princeton-rover-team/electrical/BMS Board/BMS Board.kicad_pcb

## KiCad design BMS Board/BMS Board.kicad_pcb (2026-09-24)

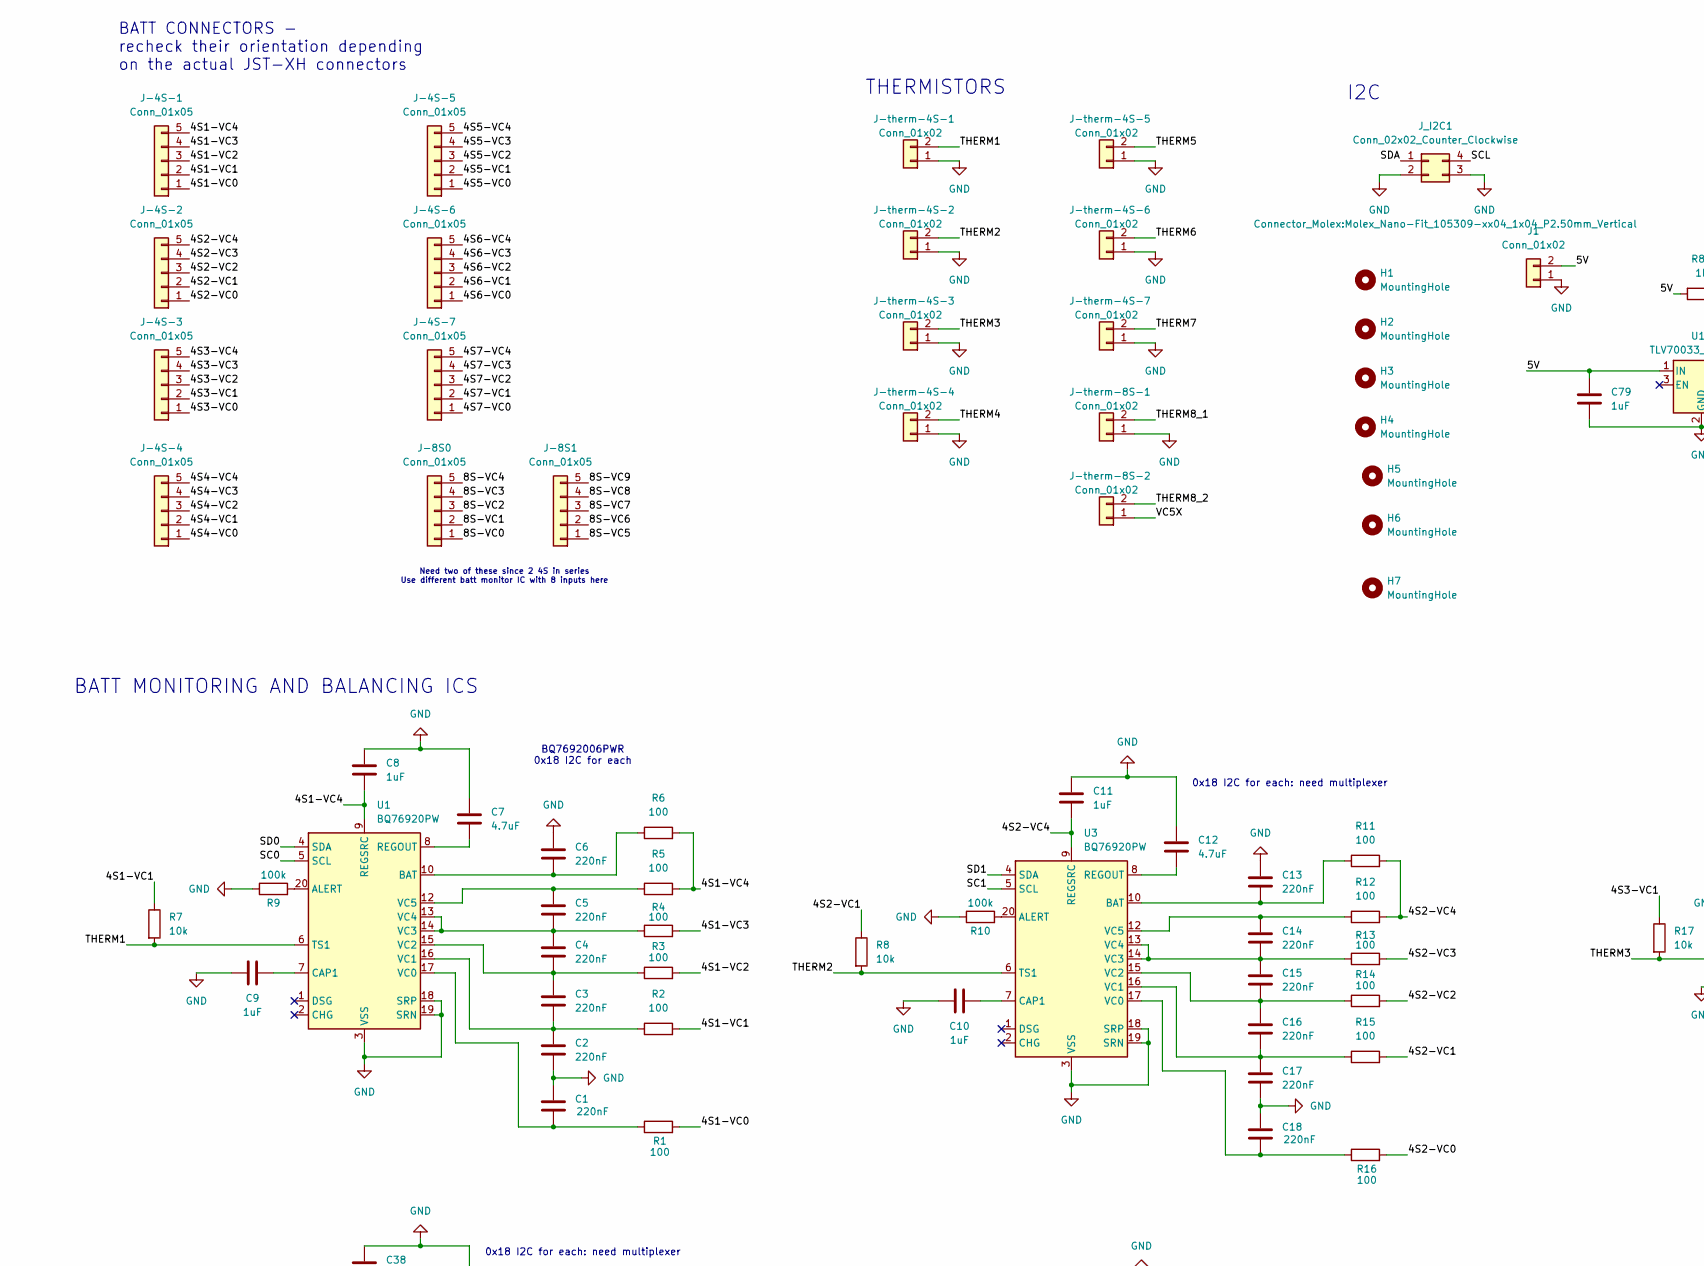
[picture p1: schematic BMS Board.kicad_sch, part in row 1, column 1]

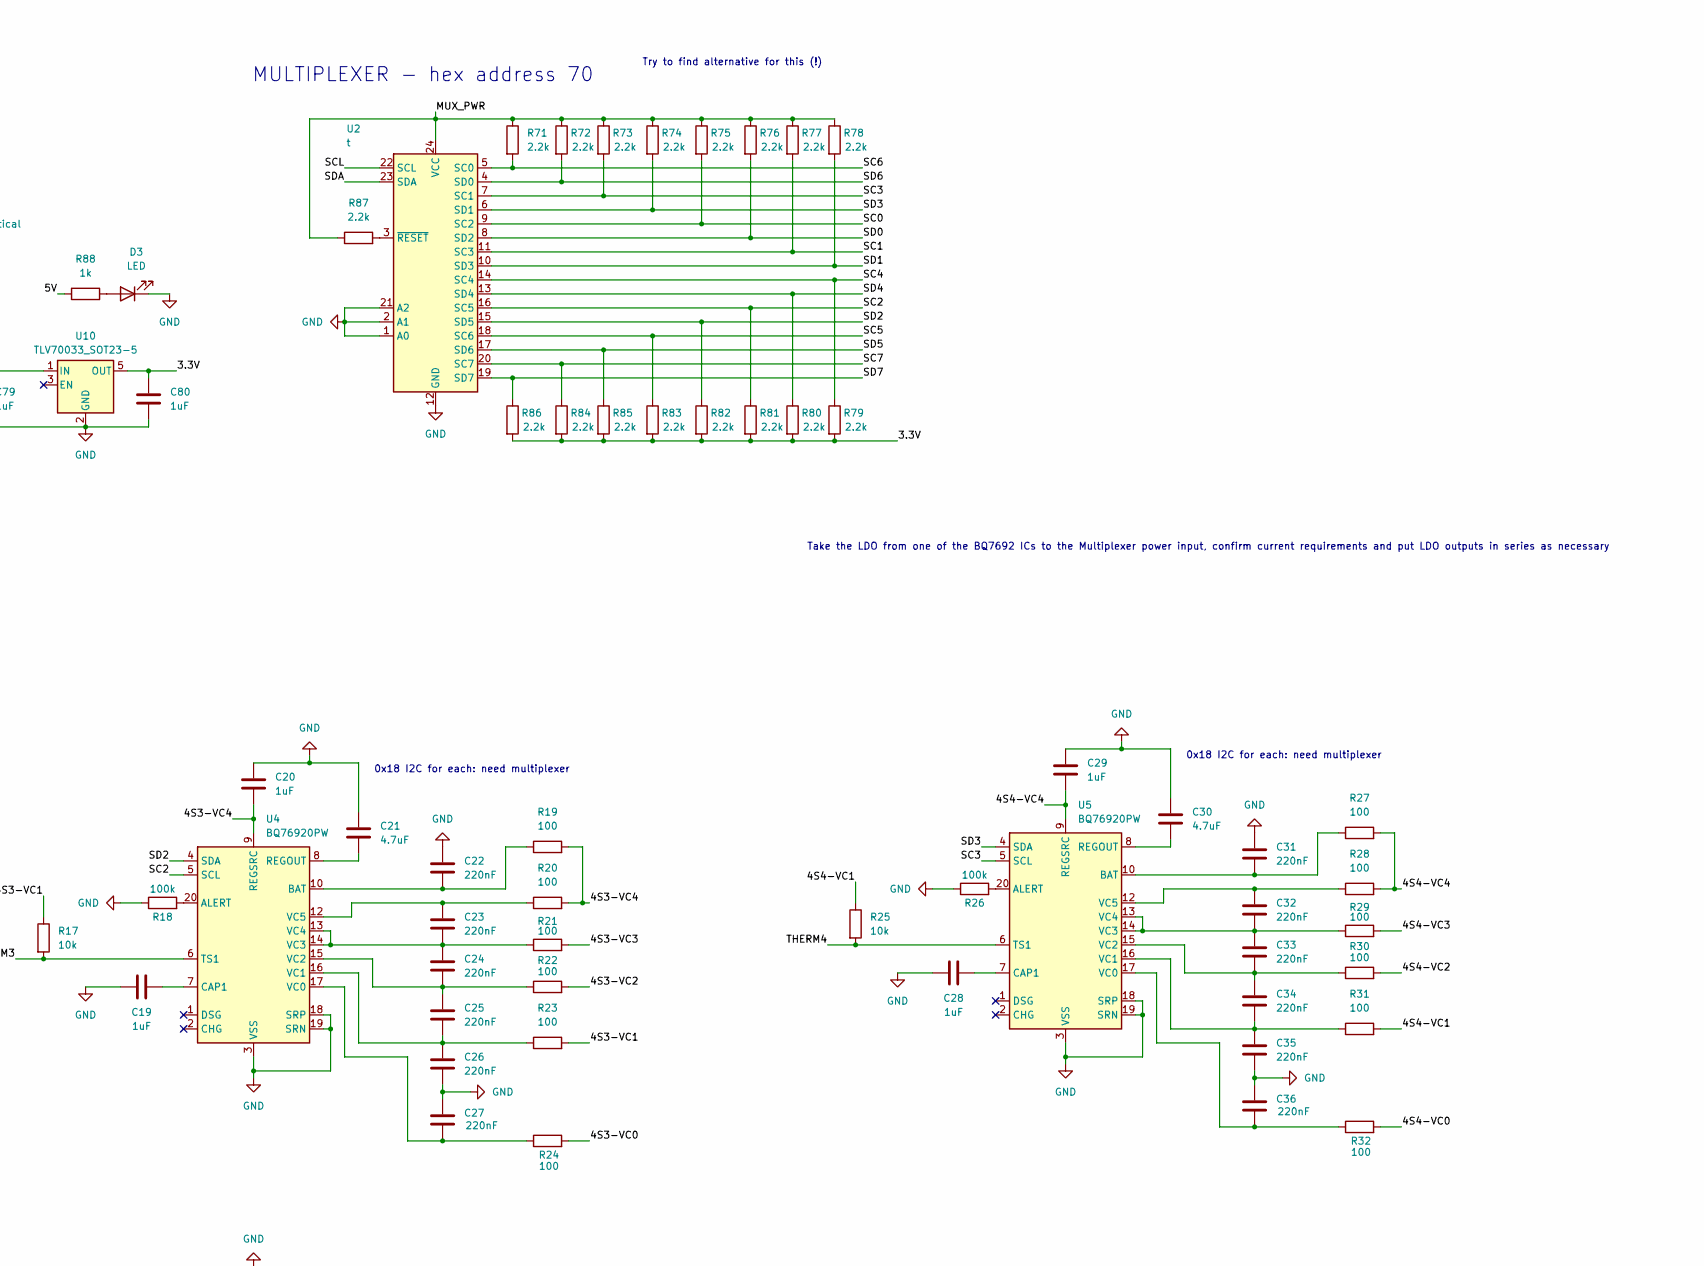
[picture p2: schematic BMS Board.kicad_sch, part in row 1, column 2]

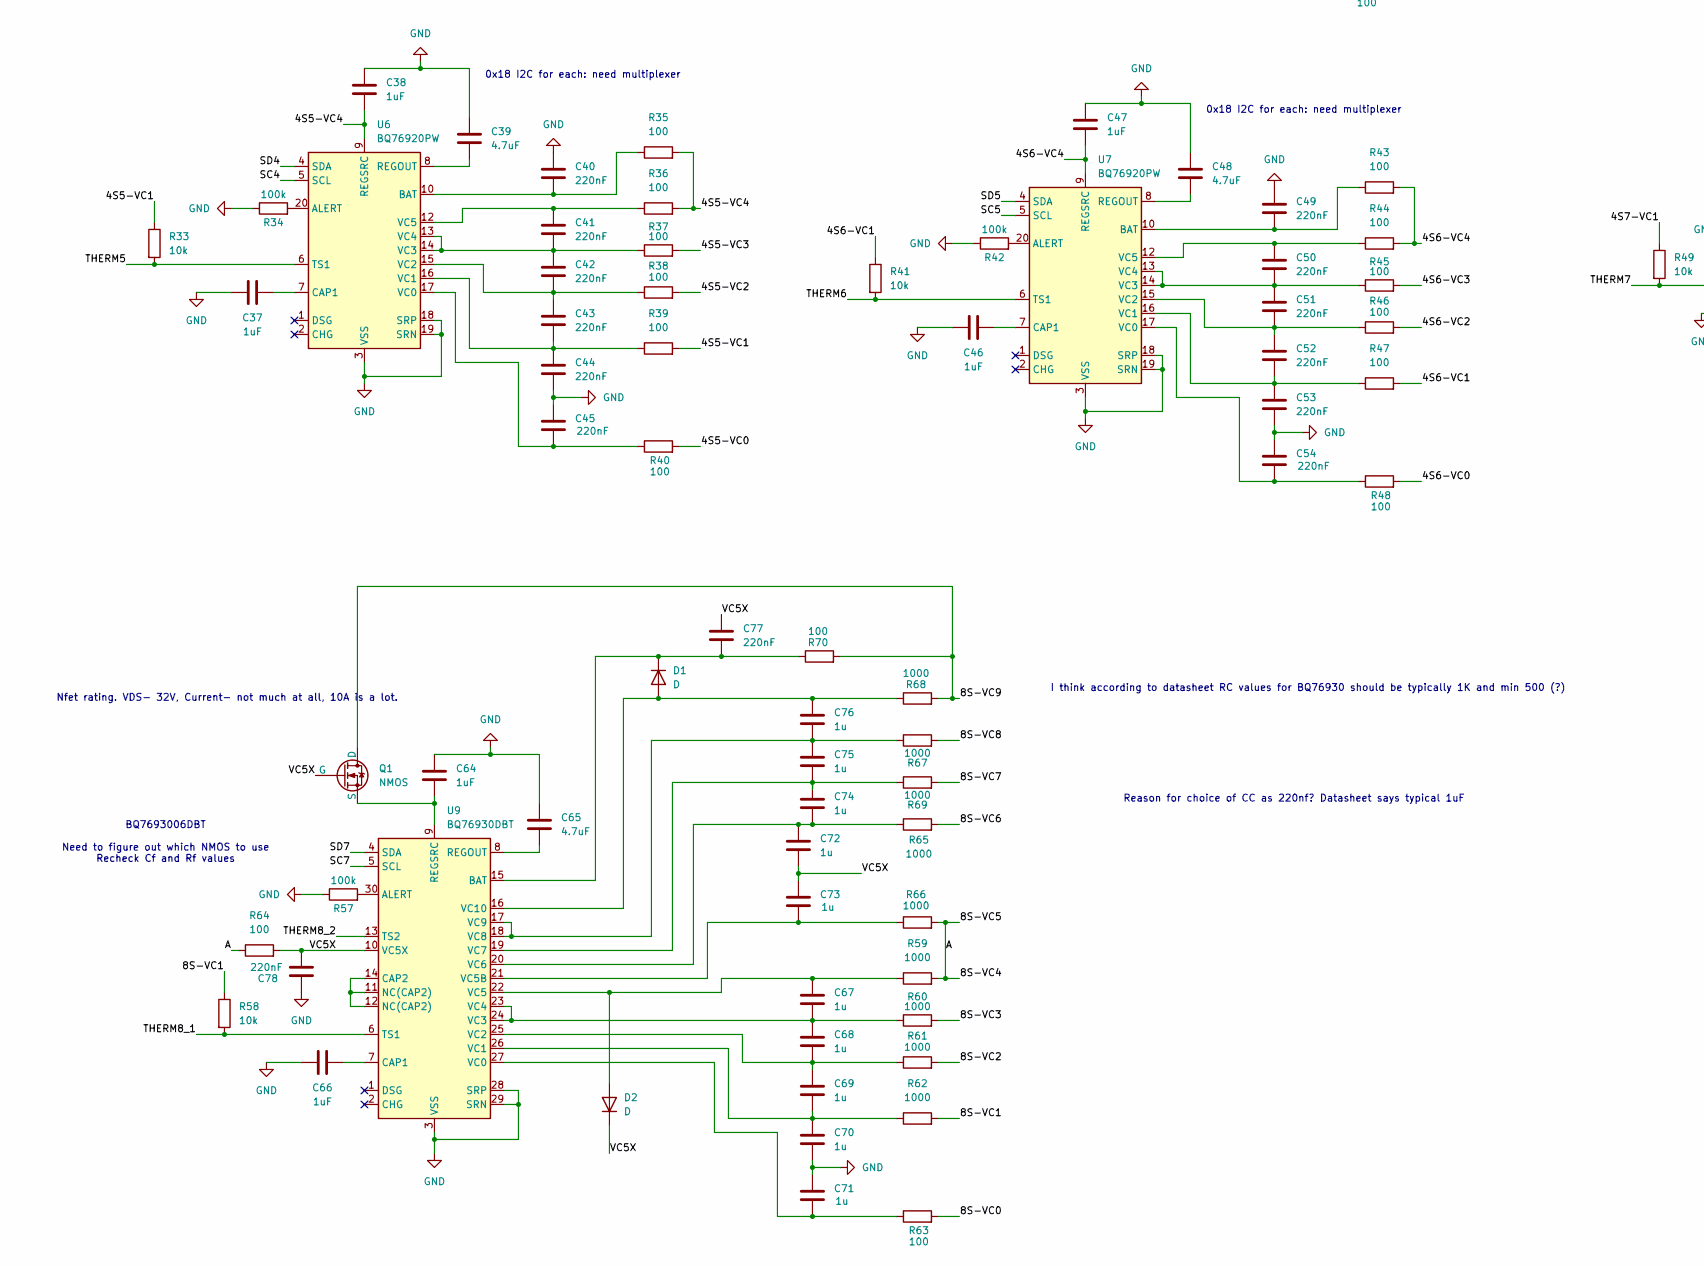
[picture p3: schematic BMS Board.kicad_sch, part in row 2, column 1]

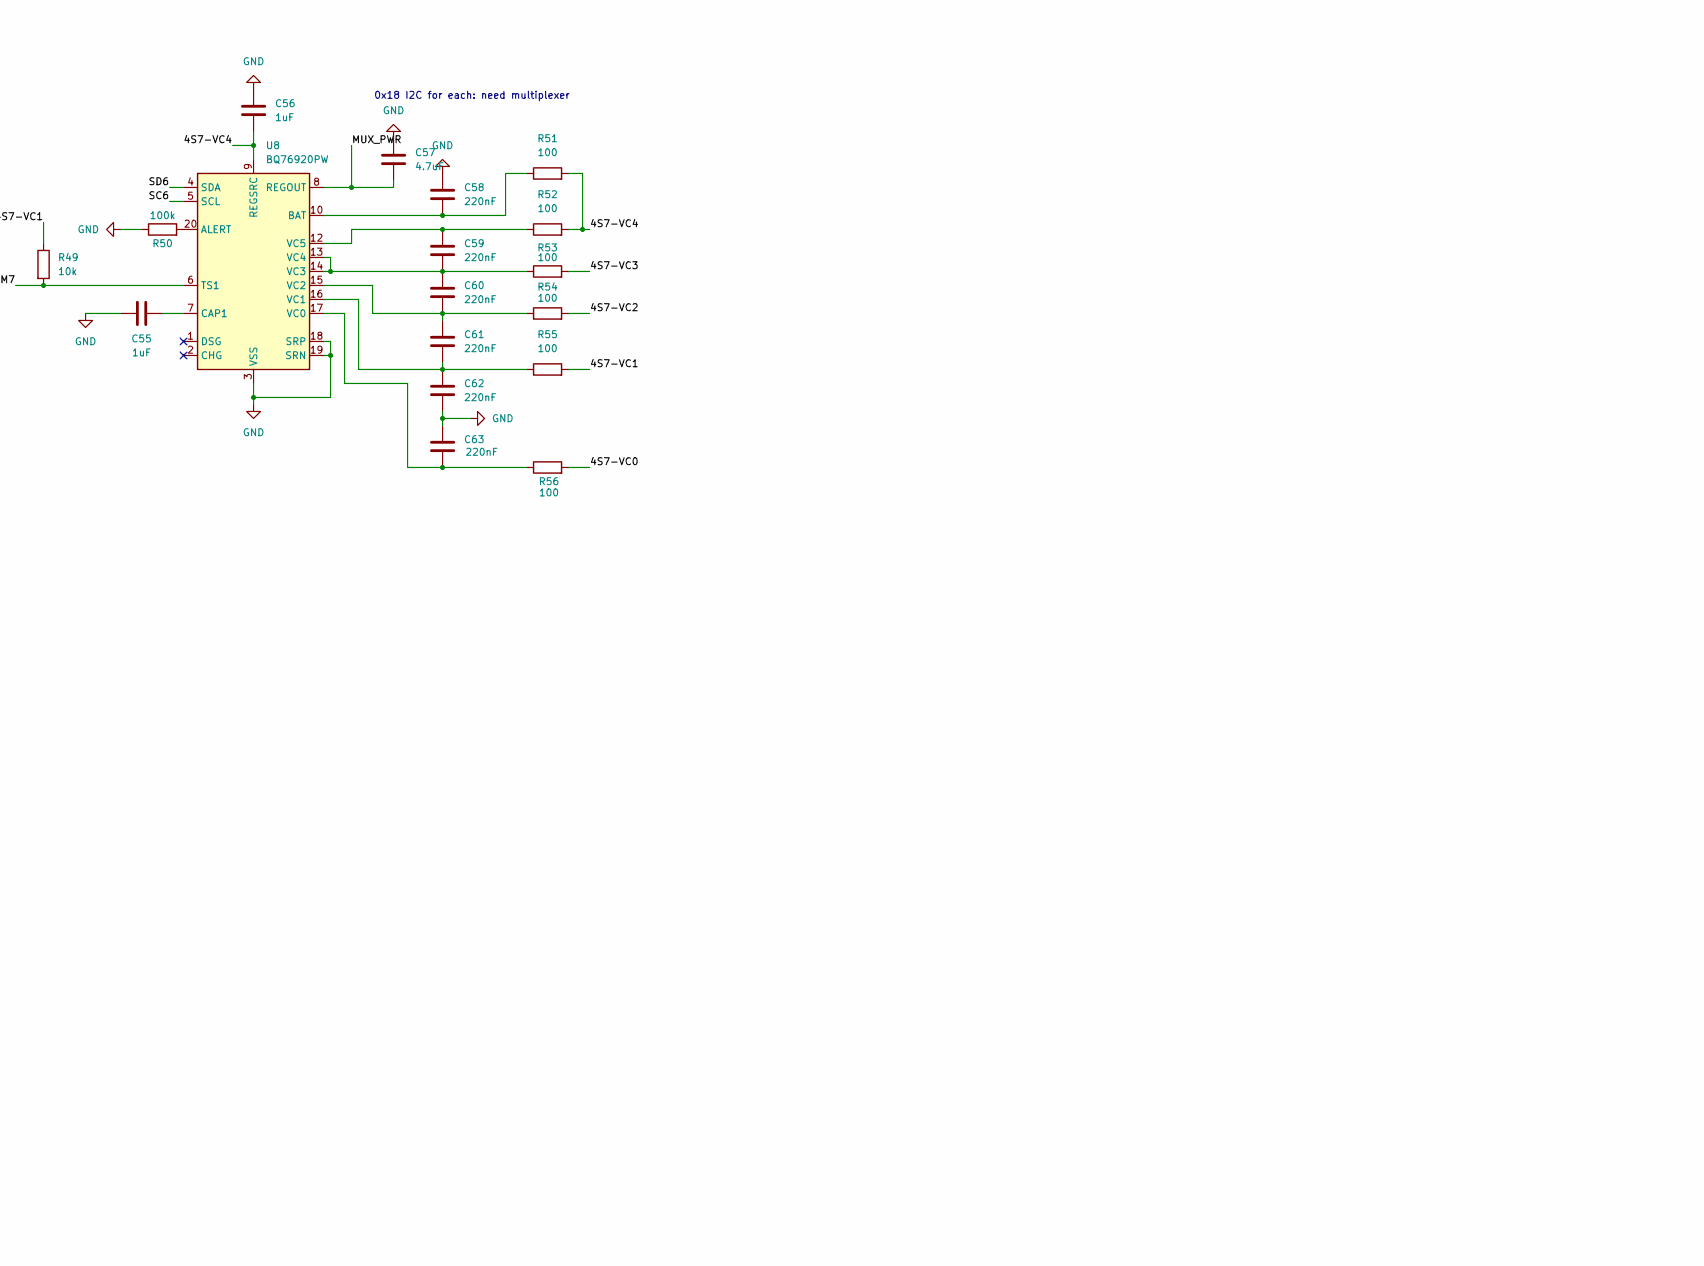
[picture p4: schematic BMS Board.kicad_sch, part in row 2, column 2]

Parts:
C1, C2, C3, C4, C5, C6, C13, C14, C15, C16, C17, C18, C22, C23, C24, C25, C26, C27, C31, C32, C33, C34, C35, C36, C40, C41, C42, C43, C44, C45, C49, C50, C51, C52, C53, C54, C58, C59, C60, C61, C62, C63, C77, C78: 220nF; C_0603_1608Metric
C7, C12, C21, C30, C39, C48, C57, C65: 4.7uF; C_0603_1608Metric
C8, C9, C10, C11, C19, C20, C28, C29, C37, C38, C46, C47, C55, C56, C64, C66, C79, C80: 1uF; C_0603_1608Metric
C67, C68, C69, C70, C71, C72, C73, C74, C75, C76: 1u; C_0603_1608Metric
D1, D2: D; D_SOD-123
D3: LED; D_0603_1608Metric
H1, H2, H3, H4, H5, H6, H7: MountingHole; MountingHole_3.2mm_M3_DIN965
J1: Conn_01x02; AMASS_XT30UPB-F_1x02_P5.0mm_Vertical
J-4S-1, J-4S-2, J-4S-3, J-4S-4, J-4S-5, J-4S-6, J-4S-7, J-8S0, J-8S1: Conn_01x05; JST_XH_B5B-XH-A_1x05_P2.50mm_Vertical
J-therm-4S-1, J-therm-4S-2, J-therm-4S-3, J-therm-4S-4, J-therm-4S-5, J-therm-4S-6, J-therm-4S-7, J-therm-8S-1, J-therm-8S-2: Conn_01x02; Molex_KK-254_AE-6410-02A_1x02_P2.54mm_Vertical; MANUFACTURER_PART_NUMBER 768290102
J_I2C1: Conn_02x02_Counter_Clockwise; Molex_Nano-Fit_105309-xx04_1x04_P2.50mm_Vertical
Q1: NMOS; SOT-23
R1, R2, R3, R4, R5, R6, R11, R12, R13, R14, R15, R16, R19, R20, R21, R22, R23, R24, R27, R28, R29, R30, R31, R32, R35, R36, R37, R38, R39, R40, R43, R44, R45, R46, R47, R48, R51, R52, R53, R54, R55, R56, R63, R64, R70: 100; C_0603_1608Metric
R7, R8, R17, R25, R33, R41, R49, R58: 10k; C_0603_1608Metric
R9, R10, R18, R26, R34, R42, R50, R57: 100k; C_0603_1608Metric
R59, R60, R61, R62, R65, R66, R67, R68, R69: 1000; C_0603_1608Metric
R71, R72, R73, R74, R75, R76, R77, R78, R79, R80, R81, R82, R83, R84, R85, R86, R87: 2.2k; C_0603_1608Metric
R88: 1k; R_0805_2012Metric
U1, U3, U4, U5, U6, U7, U8: BQ76920PW; TSSOP-20_4.4x6.5mm_P0.65mm
U2: t; TSSOP-24_4.4x7.8mm_P0.65mm
U9: BQ76930DBT; TSSOP-30_4.4x7.8mm_P0.5mm
U10: TLV70033_SOT23-5; SOT-23-5

Connections:
/3.3V: C80.1, R79.2, R80.2, R81.2, R82.2, R83.2, R84.2, R85.2, R86.2, U10.5 (OUT)
/4S1-VC0: J-4S-1.1, R1.2
/4S1-VC1: J-4S-1.2, R2.2, R7.1
/4S1-VC2: J-4S-1.3, R3.2
/4S1-VC3: J-4S-1.4, R4.2
/4S1-VC4: C8.2, J-4S-1.5, R5.2, R6.2, U1.9 (REGSRC)
/4S2-VC0: J-4S-2.1, R16.2
/4S2-VC1: J-4S-2.2, R8.1, R15.2
/4S2-VC2: J-4S-2.3, R14.2
/4S2-VC3: J-4S-2.4, R13.2
/4S2-VC4: C11.2, J-4S-2.5, R11.2, R12.2, U3.9 (REGSRC)
/4S3-VC0: J-4S-3.1, R24.2
/4S3-VC1: J-4S-3.2, R17.1, R23.2
/4S3-VC2: J-4S-3.3, R22.2
/4S3-VC3: J-4S-3.4, R21.2
/4S3-VC4: C20.2, J-4S-3.5, R19.2, R20.2, U4.9 (REGSRC)
/4S4-VC0: J-4S-4.1, R32.2
/4S4-VC1: J-4S-4.2, R25.1, R31.2
/4S4-VC2: J-4S-4.3, R30.2
/4S4-VC3: J-4S-4.4, R29.2
/4S4-VC4: C29.2, J-4S-4.5, R27.2, R28.2, U5.9 (REGSRC)
/4S5-VC0: J-4S-5.1, R40.2
/4S5-VC1: J-4S-5.2, R33.1, R39.2
/4S5-VC2: J-4S-5.3, R38.2
/4S5-VC3: J-4S-5.4, R37.2
/4S5-VC4: C38.2, J-4S-5.5, R35.2, R36.2, U6.9 (REGSRC)
/4S6-VC0: J-4S-6.1, R48.2
/4S6-VC1: J-4S-6.2, R41.1, R47.2
/4S6-VC2: J-4S-6.3, R46.2
/4S6-VC3: J-4S-6.4, R45.2
/4S6-VC4: C47.2, J-4S-6.5, R43.2, R44.2, U7.9 (REGSRC)
/4S7-VC0: J-4S-7.1, R56.2
/4S7-VC1: J-4S-7.2, R49.1, R55.2
/4S7-VC2: J-4S-7.3, R54.2
/4S7-VC3: J-4S-7.4, R53.2
/4S7-VC4: C56.2, J-4S-7.5, R51.2, R52.2, U8.9 (REGSRC)
/5V: C79.1, J1.2, R88.2, U10.1 (IN)
/8S-VC0: J-8S0.1, R63.2
/8S-VC1: J-8S0.2, R58.1, R62.2
/8S-VC2: J-8S0.3, R61.2
/8S-VC3: J-8S0.4, R60.2
/8S-VC4: J-8S0.5, J-8S1.1, R59.2, R64.1, R66.2
/8S-VC6: J-8S1.2, R65.2
/8S-VC7: J-8S1.3, R69.2
/8S-VC8: J-8S1.4, R67.2
/8S-VC9: J-8S1.5, Q1.1 (D), R68.2, R70.2
/MUX_PWR: C57.2, R71.1, R72.1, R73.1, R74.1, R75.1, R76.1, R77.1, R78.1, R87.1, U2.24 (VCC), U8.8 (REGOUT)
/SC0: R75.2, U1.5 (SCL), U2.9 (SC2)
/SC1: R77.2, U2.11 (SC3), U3.5 (SCL)
/SC2: R81.1, U2.16 (SC5), U4.5 (SCL)
/SC3: R73.2, U2.7 (SC1), U5.5 (SCL)
/SC4: R79.1, U2.14 (SC4), U6.5 (SCL)
/SC5: R83.1, U2.18 (SC6), U7.5 (SCL)
/SC6: R71.2, U2.5 (SC0), U8.5 (SCL)
/SC7: R84.1, U2.20 (SC7), U9.5 (SCL)
/SCL: J_I2C1.4, U2.22 (SCL)
/SD0: R76.2, U1.4 (SDA), U2.8 (SD2)
/SD1: R78.2, U2.10 (SD3), U3.4 (SDA)
/SD2: R82.1, U2.15 (SD5), U4.4 (SDA)
/SD3: R74.2, U2.6 (SD1), U5.4 (SDA)
/SD4: R80.1, U2.13 (SD4), U6.4 (SDA)
/SD5: R85.1, U2.17 (SD6), U7.4 (SDA)
/SD6: R72.2, U2.4 (SD0), U8.4 (SDA)
/SD7: R86.1, U2.19 (SD7), U9.4 (SDA)
/SDA: J_I2C1.1, U2.23 (SDA)
/THERM1: J-therm-4S-1.2, R7.2, U1.6 (TS1)
/THERM2: J-therm-4S-2.2, R8.2, U3.6 (TS1)
/THERM3: J-therm-4S-3.2, R17.2, U4.6 (TS1)
/THERM4: J-therm-4S-4.2, R25.2, U5.6 (TS1)
/THERM5: J-therm-4S-5.2, R33.2, U6.6 (TS1)
/THERM6: J-therm-4S-6.2, R41.2, U7.6 (TS1)
/THERM7: J-therm-4S-7.2, R49.2, U8.6 (TS1)
/THERM8_1: J-therm-8S-1.2, R58.2, U9.6 (TS1)
/THERM8_2: J-therm-8S-2.2, U9.13 (TS2)
/VC5X: C72.2, C73.1, C77.1, C78.2, D2.1 (K), J-therm-8S-2.1, Q1.2 (G), R64.2, U9.10 (VC5X)
GND: C1.1, C2.2, C6.1, C7.1, C8.1, C9.2, C10.2, C11.1, C12.1, C13.1, C17.2, C18.1, C19.2, C20.1, C21.1, C22.1, C26.2, C27.1, C28.2, C29.1, C30.1, C31.1, C35.2, C36.1, C37.2, C38.1, C39.1, C40.1, C44.2, C45.1, C46.2, C47.1, C48.1, C49.1, C53.2, C54.1, C55.2, C56.1, C57.1, C58.1, C62.2, C63.1, C64.1, C65.1, C66.2, C70.2, C71.1, C78.1, C79.2, C80.2, D3.1 (K), J1.1, J-therm-4S-1.1, J-therm-4S-2.1, J-therm-4S-3.1, J-therm-4S-4.1, J-therm-4S-5.1, J-therm-4S-6.1, J-therm-4S-7.1, J-therm-8S-1.1, J_I2C1.2, J_I2C1.3, R9.1, R10.1, R18.1, R26.1, R34.1, R42.1, R50.1, R57.1, U1.3 (VSS), U1.18 (SRP), U1.19 (SRN), U2.1 (A0), U2.2 (A1), U2.12 (GND), U2.21 (A2), U3.3 (VSS), U3.18 (SRP), U3.19 (SRN), U4.3 (VSS), U4.18 (SRP), U4.19 (SRN), U5.3 (VSS), U5.18 (SRP), U5.19 (SRN), U6.3 (VSS), U6.18 (SRP), U6.19 (SRN), U7.3 (VSS), U7.18 (SRP), U7.19 (SRN), U8.3 (VSS), U8.18 (SRP), U8.19 (SRN), U9.3 (VSS), U9.28 (SRP), U9.29 (SRN), U10.2 (GND)
unnamed: C76.1, D1.2 (A), R68.1, U9.16 (VC10)
unnamed: C77.2, D1.1 (K), R70.1, U9.15 (BAT)
unnamed: C67.1, D2.2 (A), R59.1, U9.22 (VC5)
unnamed: D3.2 (A), R88.1
unnamed: C64.2, Q1.3 (S), U9.9 (REGSRC)
unnamed: R9.2, U1.20 (ALERT)
unnamed: C6.2, R6.1, U1.10 (BAT)
unnamed: C9.1, U1.7 (CAP1)
unnamed: C7.2, U1.8 (REGOUT)
unnamed: C1.2, R1.1, U1.17 (VC0)
unnamed: C2.1, C3.2, R2.1, U1.16 (VC1)
unnamed: C3.1, C4.2, R3.1, U1.15 (VC2)
unnamed: C4.1, C5.2, R4.1, U1.13 (VC4), U1.14 (VC3)
unnamed: C5.1, R5.1, U1.12 (VC5)
unnamed: R87.2, U2.3 (~RESET)
unnamed: R10.2, U3.20 (ALERT)
unnamed: C13.2, R11.1, U3.10 (BAT)
unnamed: C10.1, U3.7 (CAP1)
unnamed: C12.2, U3.8 (REGOUT)
unnamed: C18.2, R16.1, U3.17 (VC0)
unnamed: C16.2, C17.1, R15.1, U3.16 (VC1)
unnamed: C15.2, C16.1, R14.1, U3.15 (VC2)
unnamed: C14.2, C15.1, R13.1, U3.13 (VC4), U3.14 (VC3)
unnamed: C14.1, R12.1, U3.12 (VC5)
unnamed: R18.2, U4.20 (ALERT)
unnamed: C22.2, R19.1, U4.10 (BAT)
unnamed: C19.1, U4.7 (CAP1)
unnamed: C21.2, U4.8 (REGOUT)
unnamed: C27.2, R24.1, U4.17 (VC0)
unnamed: C25.2, C26.1, R23.1, U4.16 (VC1)
unnamed: C24.2, C25.1, R22.1, U4.15 (VC2)
unnamed: C23.2, C24.1, R21.1, U4.13 (VC4), U4.14 (VC3)
unnamed: C23.1, R20.1, U4.12 (VC5)
unnamed: R26.2, U5.20 (ALERT)
unnamed: C31.2, R27.1, U5.10 (BAT)
unnamed: C28.1, U5.7 (CAP1)
unnamed: C30.2, U5.8 (REGOUT)
unnamed: C36.2, R32.1, U5.17 (VC0)
unnamed: C34.2, C35.1, R31.1, U5.16 (VC1)
unnamed: C33.2, C34.1, R30.1, U5.15 (VC2)
unnamed: C32.2, C33.1, R29.1, U5.13 (VC4), U5.14 (VC3)
unnamed: C32.1, R28.1, U5.12 (VC5)
unnamed: R34.2, U6.20 (ALERT)
unnamed: C40.2, R35.1, U6.10 (BAT)
unnamed: C37.1, U6.7 (CAP1)
unnamed: C39.2, U6.8 (REGOUT)
unnamed: C45.2, R40.1, U6.17 (VC0)
unnamed: C43.2, C44.1, R39.1, U6.16 (VC1)
unnamed: C42.2, C43.1, R38.1, U6.15 (VC2)
unnamed: C41.2, C42.1, R37.1, U6.13 (VC4), U6.14 (VC3)
unnamed: C41.1, R36.1, U6.12 (VC5)
unnamed: R42.2, U7.20 (ALERT)
unnamed: C49.2, R43.1, U7.10 (BAT)
unnamed: C46.1, U7.7 (CAP1)
unnamed: C48.2, U7.8 (REGOUT)
unnamed: C54.2, R48.1, U7.17 (VC0)
unnamed: C52.2, C53.1, R47.1, U7.16 (VC1)
unnamed: C51.2, C52.1, R46.1, U7.15 (VC2)
unnamed: C50.2, C51.1, R45.1, U7.13 (VC4), U7.14 (VC3)
unnamed: C50.1, R44.1, U7.12 (VC5)
unnamed: R50.2, U8.20 (ALERT)
unnamed: C58.2, R51.1, U8.10 (BAT)
unnamed: C55.1, U8.7 (CAP1)
unnamed: C63.2, R56.1, U8.17 (VC0)
unnamed: C61.2, C62.1, R55.1, U8.16 (VC1)
unnamed: C60.2, C61.1, R54.1, U8.15 (VC2)
unnamed: C59.2, C60.1, R53.1, U8.13 (VC4), U8.14 (VC3)
unnamed: C59.1, R52.1, U8.12 (VC5)
unnamed: R57.2, U9.30 (ALERT)
unnamed: C66.1, U9.7 (CAP1)
unnamed: U9.11 (NC(CAP2)), U9.12 (NC(CAP2)), U9.14 (CAP2)
unnamed: C65.2, U9.8 (REGOUT)
unnamed: C71.2, R63.1, U9.27 (VC0)
unnamed: C69.2, C70.1, R62.1, U9.26 (VC1)
unnamed: C68.2, C69.1, R61.1, U9.25 (VC2)
unnamed: C67.2, C68.1, R60.1, U9.23 (VC4), U9.24 (VC3)
unnamed: C73.2, R66.1, U9.21 (VC5B)
unnamed: C72.1, C74.2, R65.1, U9.20 (VC6)
unnamed: C74.1, C75.2, R69.1, U9.19 (VC7)
unnamed: C75.1, C76.2, R67.1, U9.17 (VC9), U9.18 (VC8)

Notes on the sheet:
Reason for choice of CC as 220nf? Datasheet says typical 1uF
0x18 I2C for each: need multiplexer
Need two of these since 2 4S in series Use different batt monitor IC with 8 inputs here
I2C
BATT MONITORING AND BALANCING ICS
Take the LDO from one of the BQ7692 ICs to the Multiplexer power input, confirm current requirements and put LDO outputs in series as necessary
THERMISTORS
BATT CONNECTORS - recheck their orientation depending on the actual JST-XH connectors
I think according to datasheet RC values for BQ76930 should be typically 1K and min 500 (?)
BQ7692006PWR 0x18 I2C for each
MULTIPLEXER - hex address 70
Try to find alternative for this (!)
Nfet rating. VDS- 32V, Current- not much at all, 10A is a lot.
BQ7693006DBT Need to figure out which NMOS to use Recheck Cf and Rf values

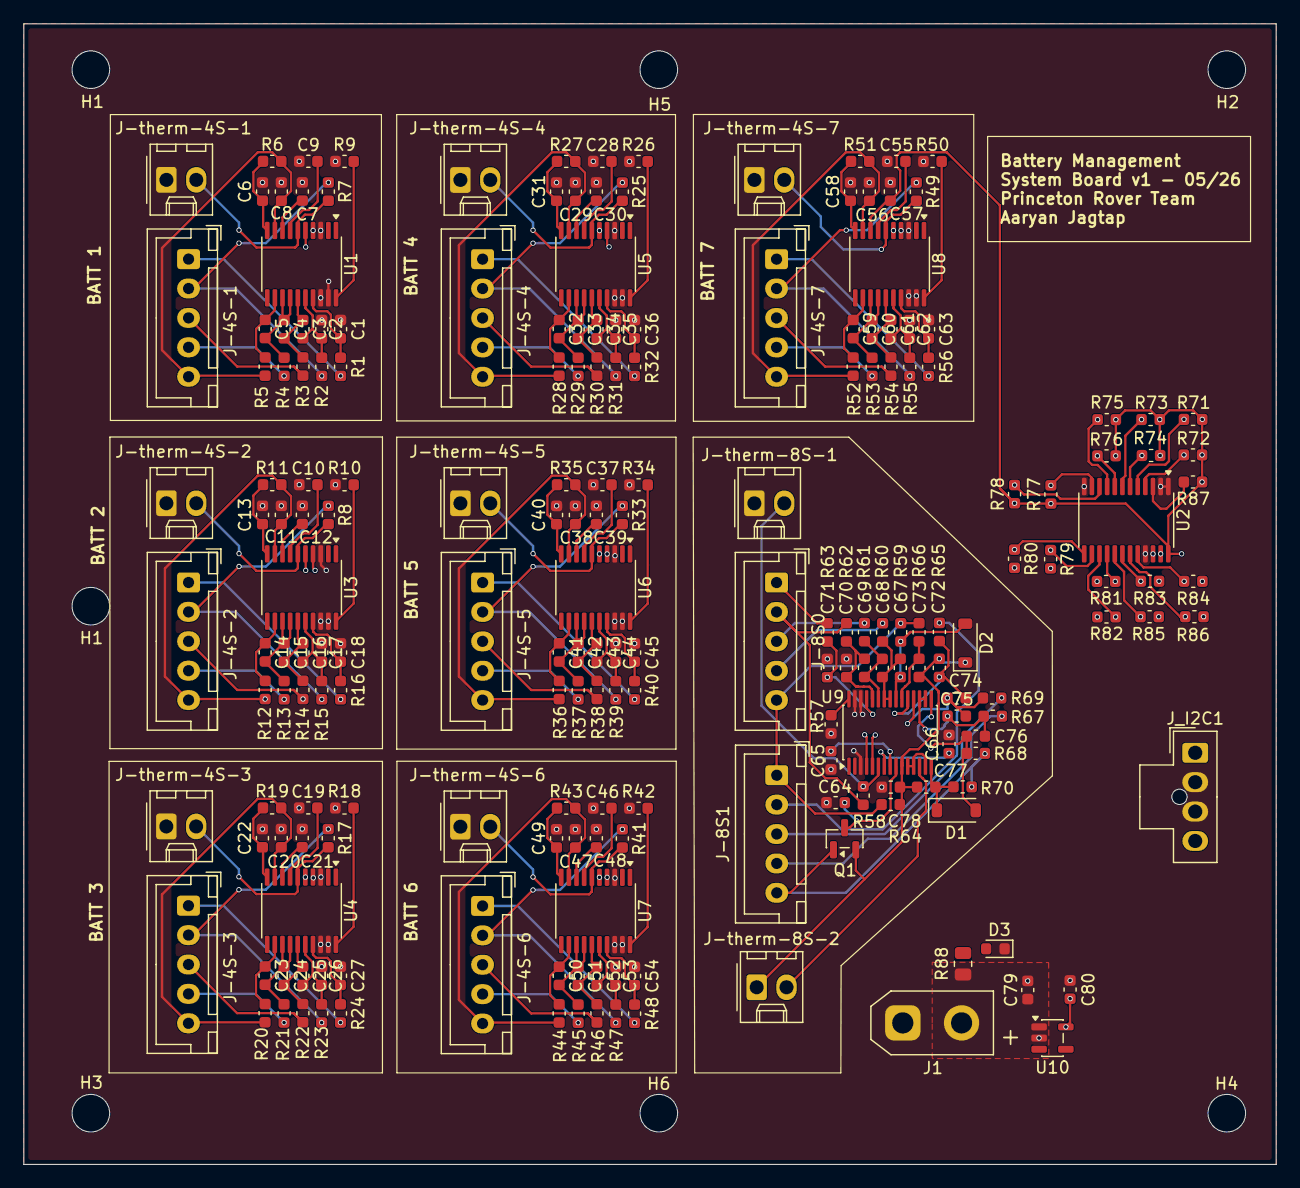
[picture p5: board BMS Board.kicad_pcb from above]

Board: 4 copper layers, 106.5 x 97.0 mm, 209 parts (0 on the bottom side), 156 nets.

Other parts of the board:
H1#2: MountingHole; MountingHole_3.2mm_M3_DIN965
