princeton-rover-team/electrical/Power Board 2/Power Board.kicad_pcb

## KiCad design Power Board 2/Power Board.kicad_pcb (2026-05-28)

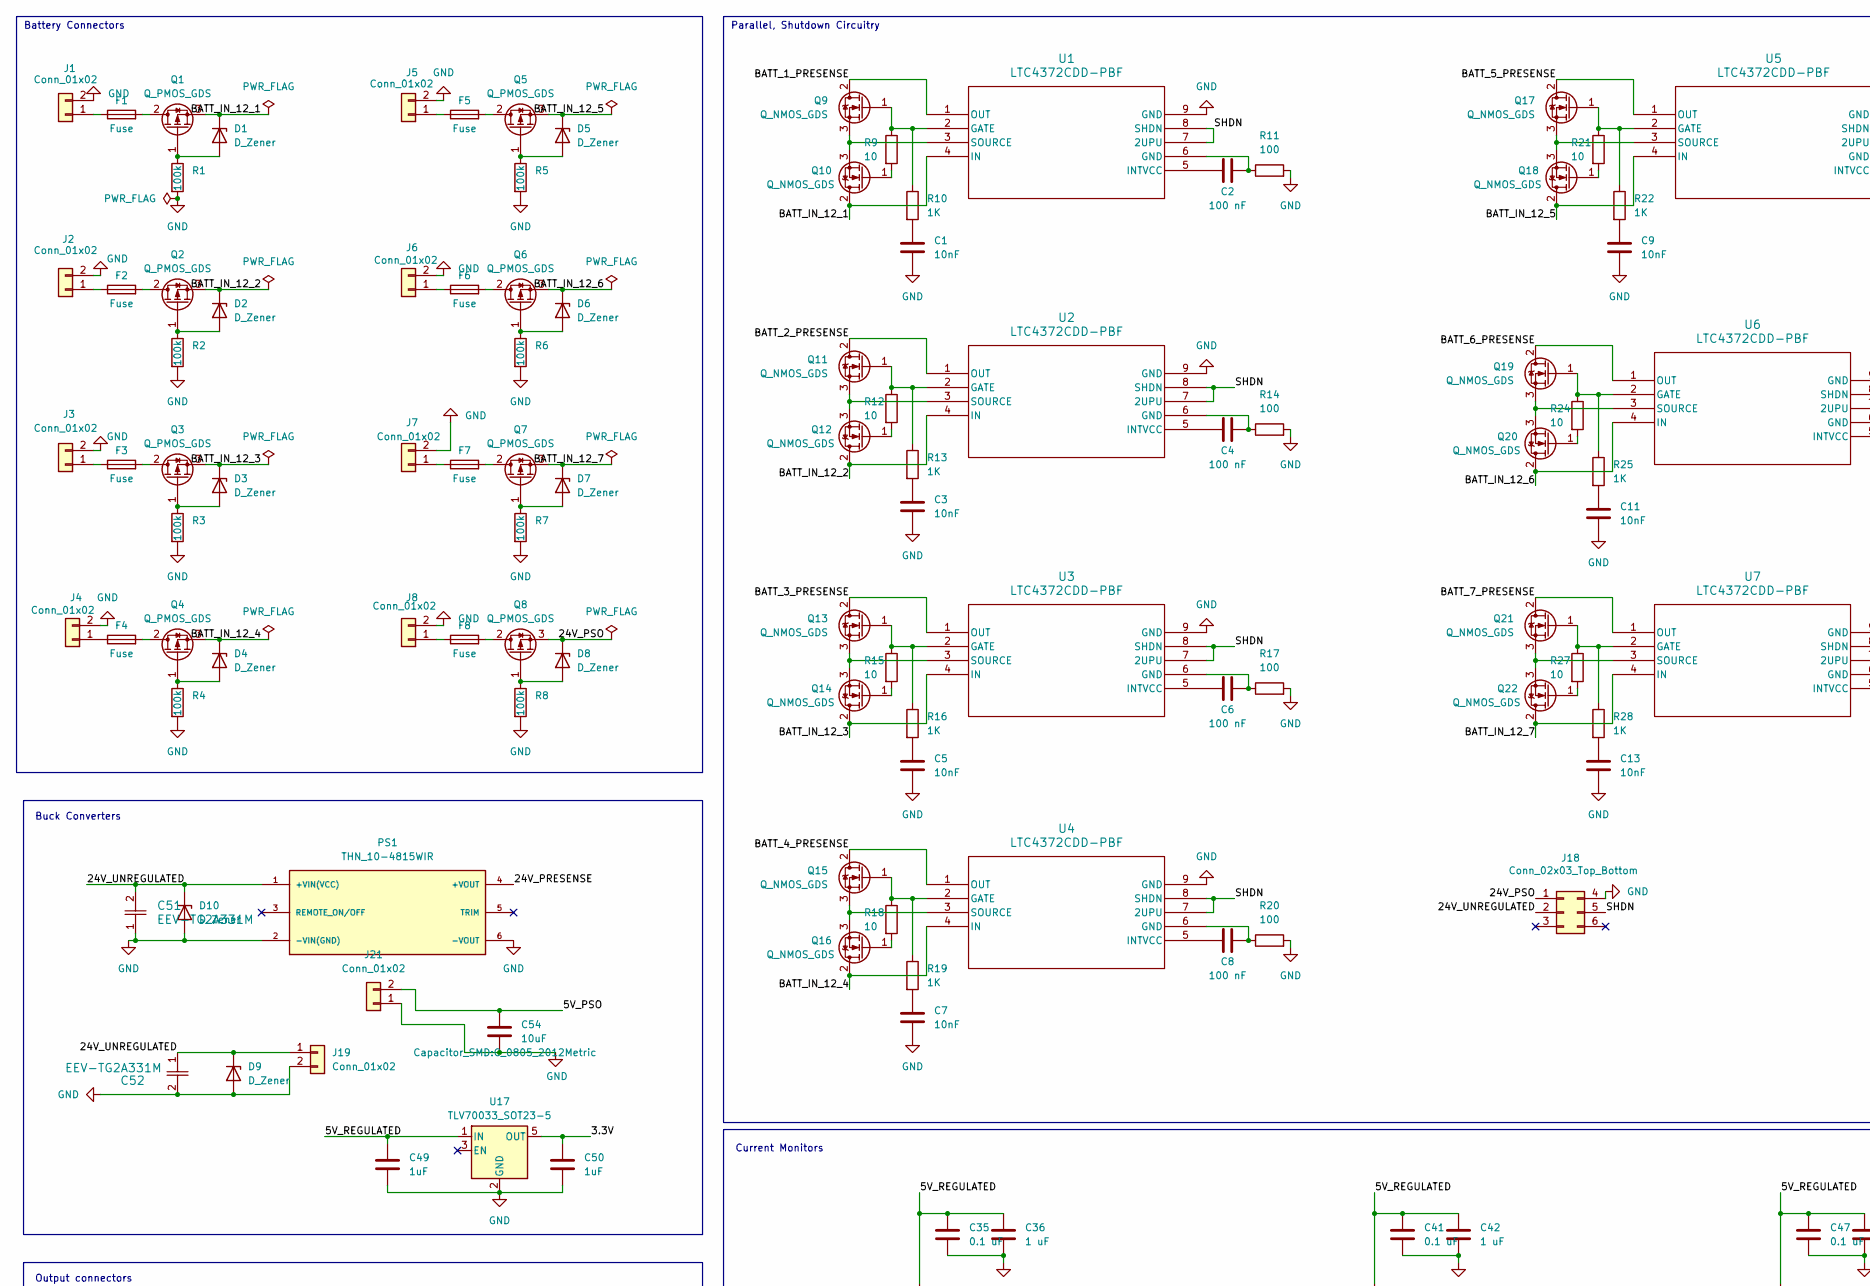
[picture p6: schematic Power Board.kicad_sch, part in row 1, column 1]

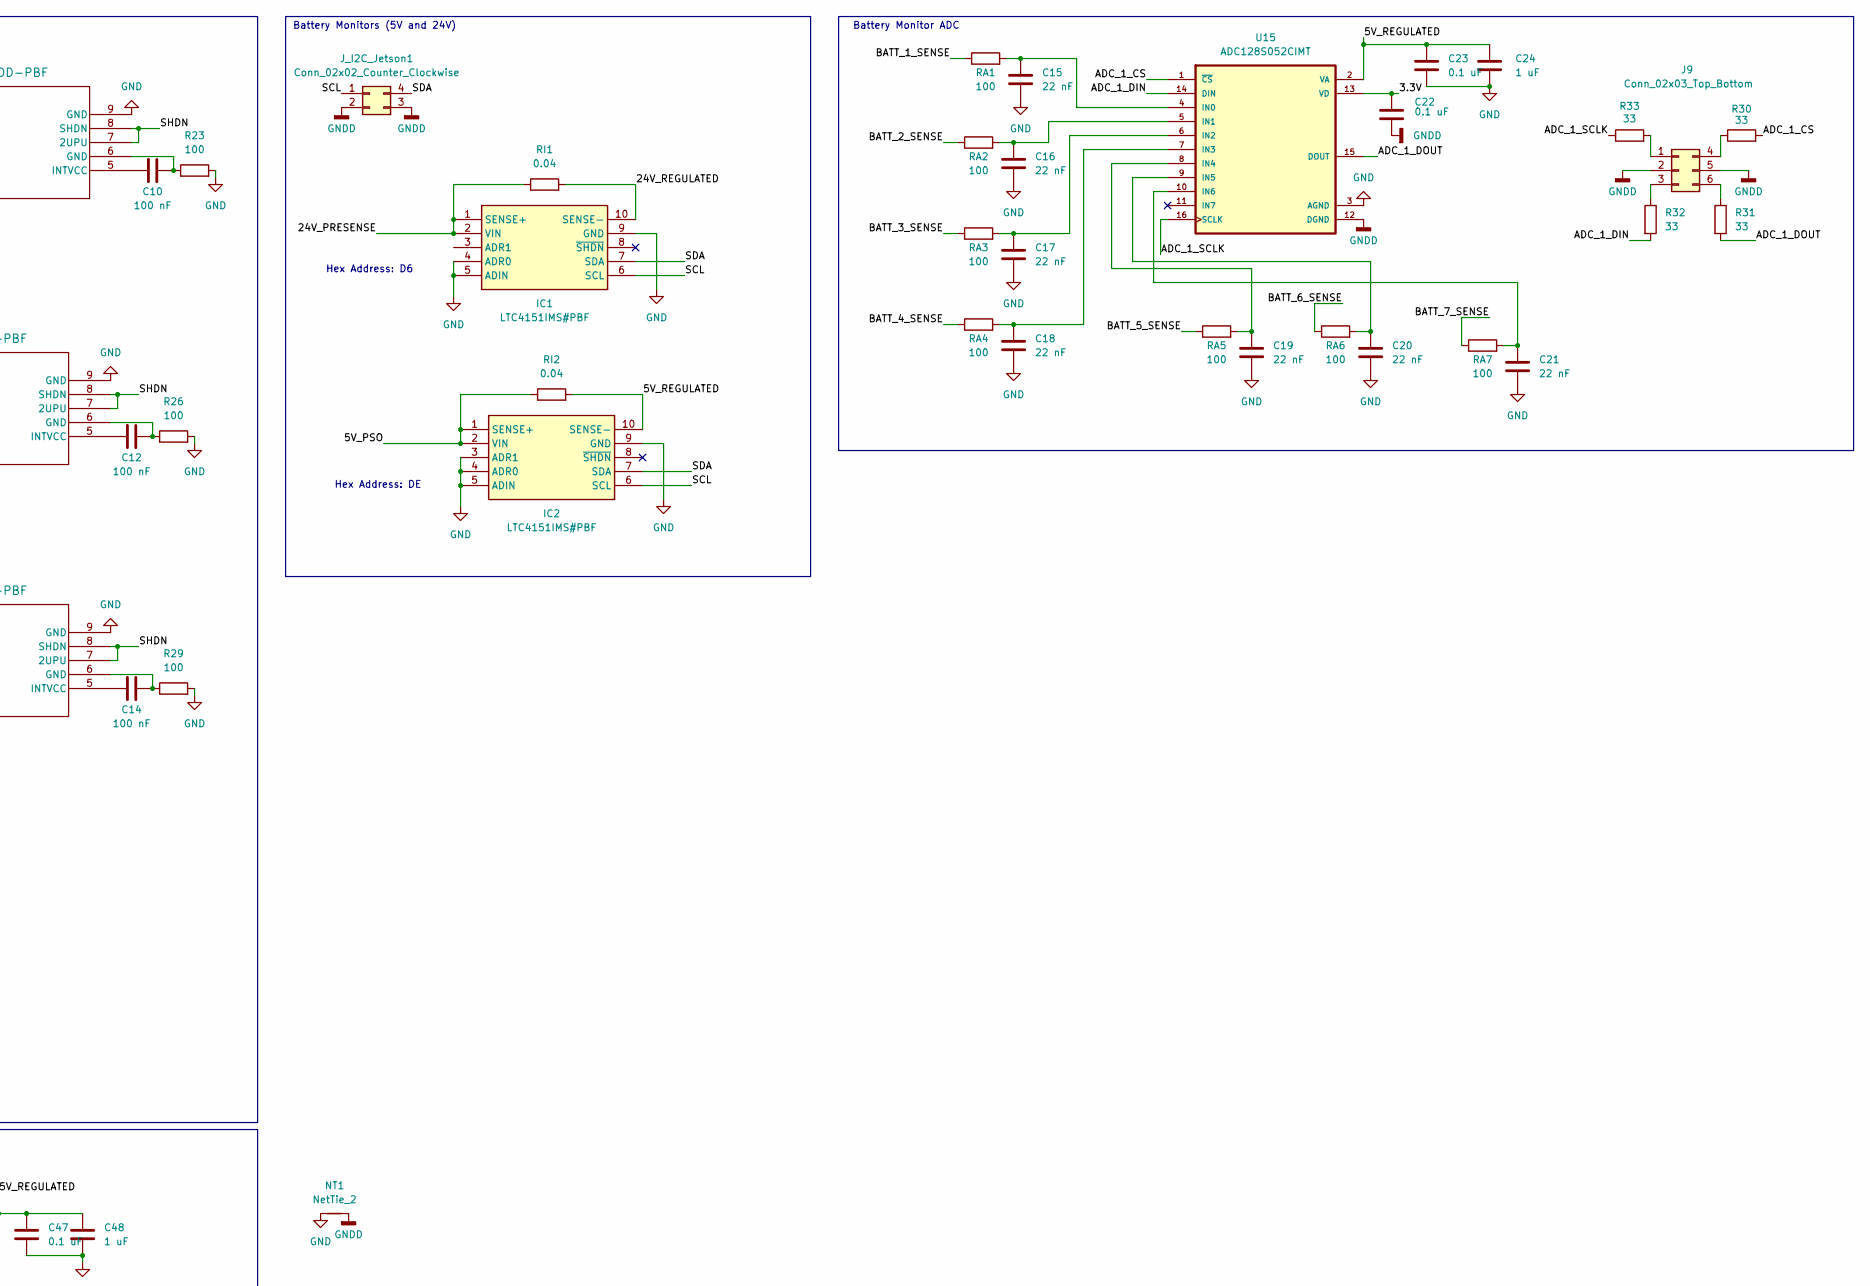
[picture p7: schematic Power Board.kicad_sch, part in row 1, column 2]

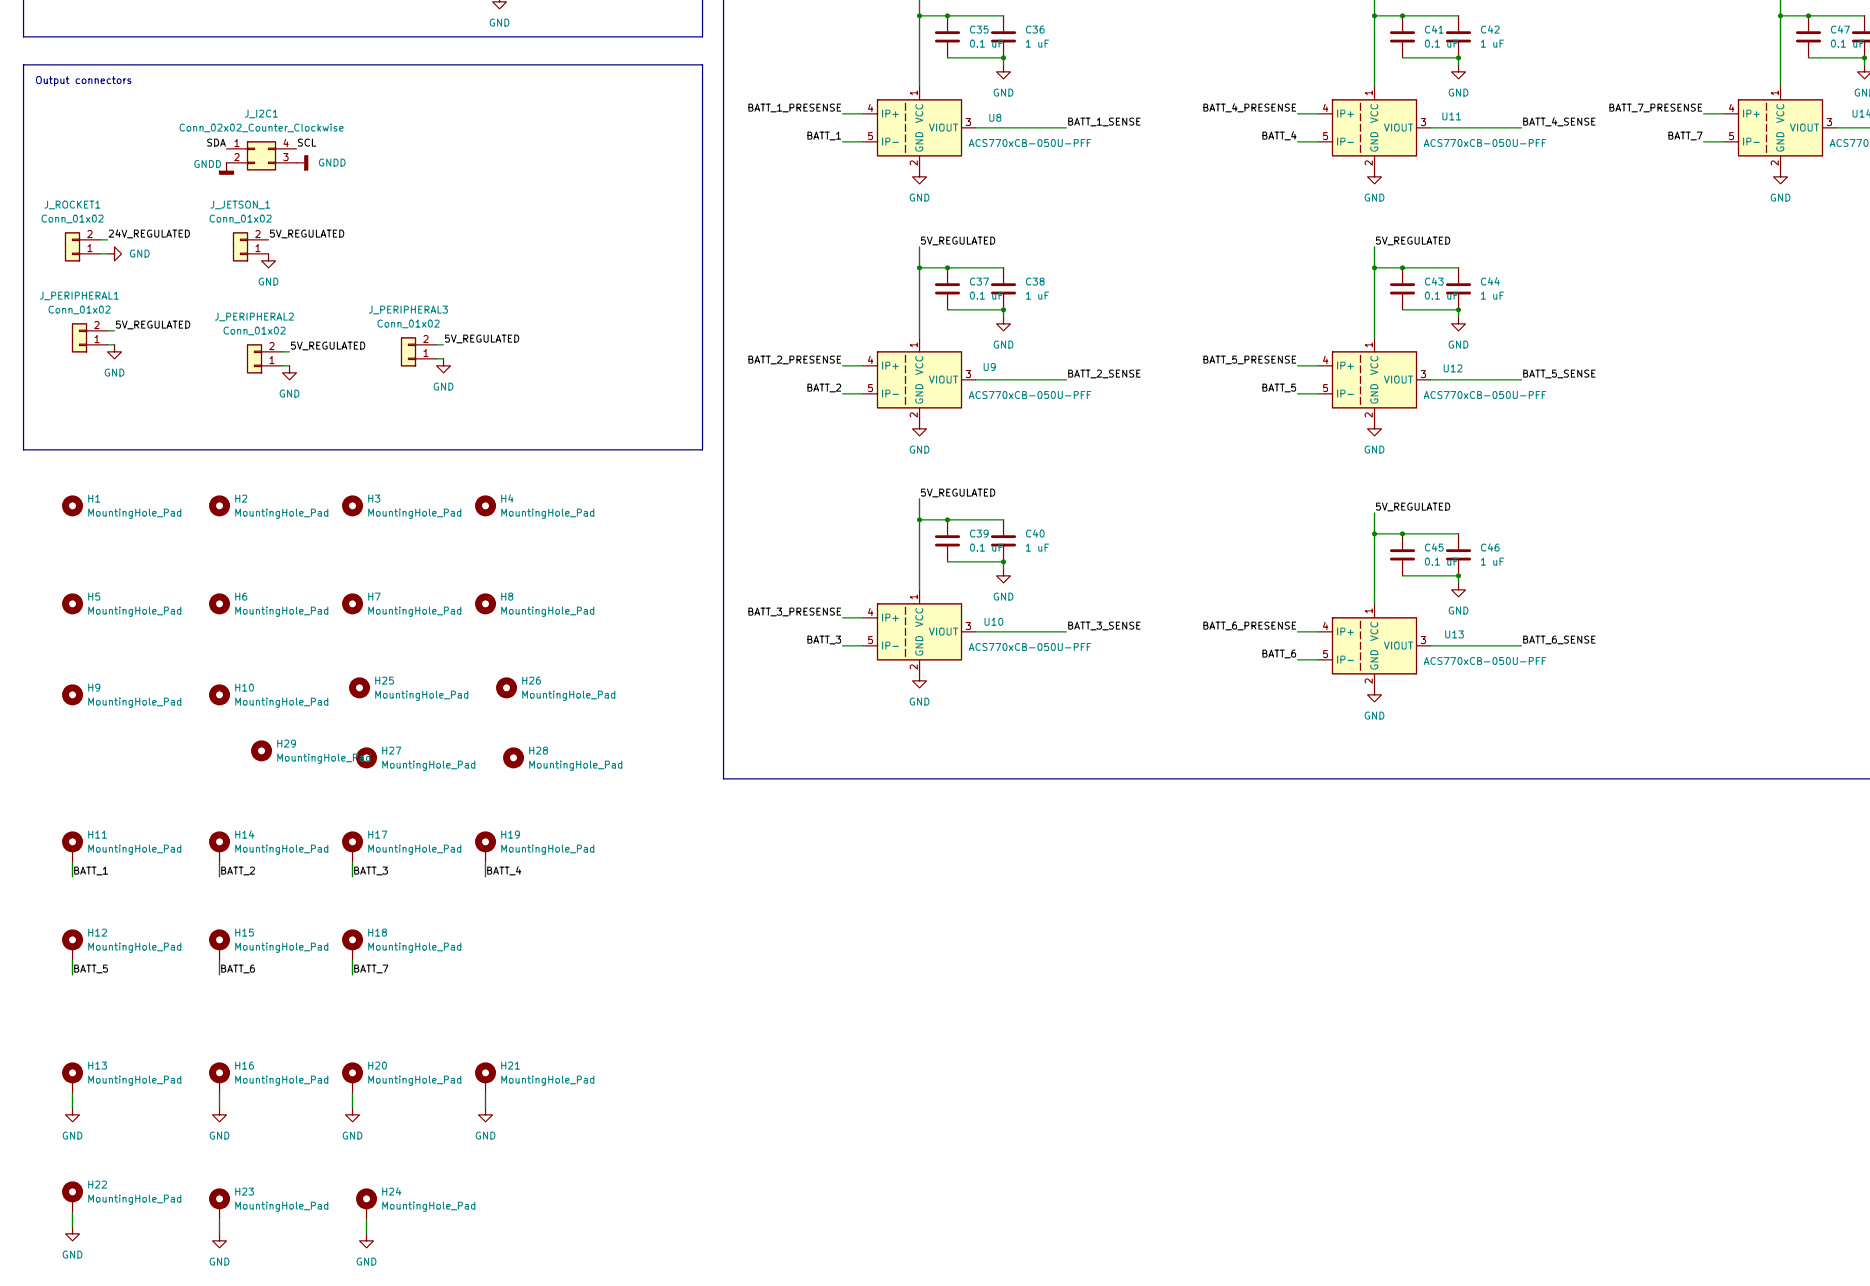
[picture p8: schematic Power Board.kicad_sch, part in row 2, column 1]

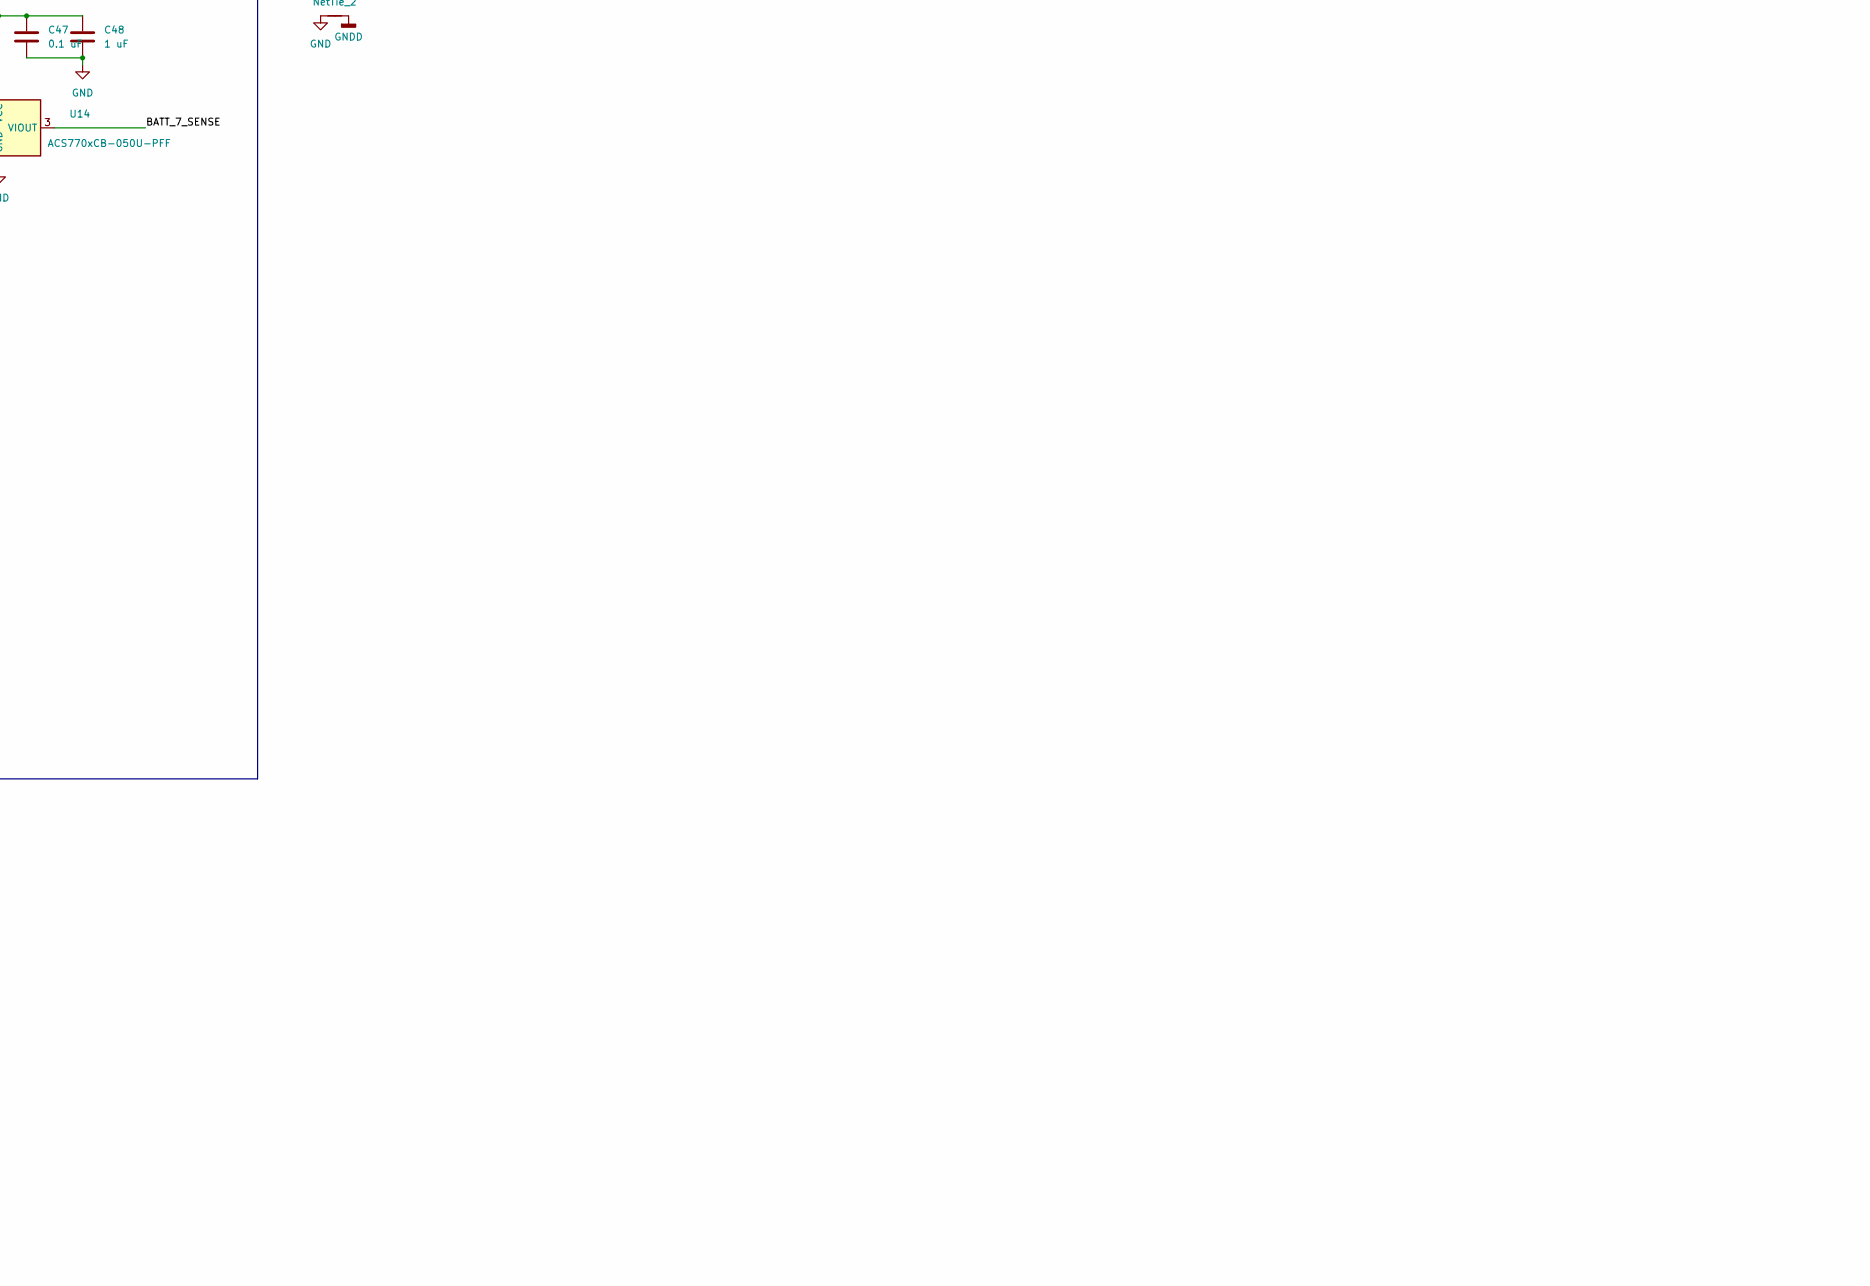
[picture p9: schematic Power Board.kicad_sch, part in row 2, column 2]

Parts:
C1, C3, C5, C7, C9, C11, C13: 10nF; C_0603_1608Metric
C2, C4, C6, C8, C10, C12, C14: 100 nF; C_0603_1608Metric
C15, C16, C17, C18, C19, C20, C21: 22 nF; C_0603_1608Metric
C22, C23, C35, C37, C39, C41, C43, C45, C47: 0.1 uF; C_0603_1608Metric
C24, C36, C38, C40, C42, C44, C46, C48: 1 uF; C_0603_1608Metric
C49, C50: 1uF; C_0603_1608Metric
C51, C52: EEV-TG2A331M; CAP_SMD_19X19_PAN
C54: 10uF; C_0805_2012Metric
D1, D2, D3, D4, D5, D6, D7, D8: D_Zener; D_SOD-123; MANUFACTURER_PART_NUMBER BZT52C10-TP
D9, D10: D_Zener; D_SMB
F1, F2, F3, F4, F5, F6, F7, F8: Fuse; Fuse_0498060M
H1, H2, H3, H4, H5, H6, H7, H8, H9, H10, H25, H26, H27, H28, H29: MountingHole_Pad; MountingHole_3.2mm_M3_DIN965
H11, H12, H13, H14, H15, H16, H17, H18, H19, H20, H21, H22, H23, H24: MountingHole_Pad; MountingHole_4.3mm_M4_DIN965_Pad
IC1, IC2: LTC4151IMS#PBF; MSOP-10_3x3mm_P0.5mm; Mouser Part Number 584-LTC4151IMS#PBF
J1, J2, J3, J4, J5, J6, J7, J8: Conn_01x02; AMASS_XT60PW-F_1x02_P7.20mm_Horizontal; MANUFACTURER_PART_NUMBER 768290102
J9: Conn_02x03_Top_Bottom; Molex_Nano-Fit_105314-xx06_2x03_P2.50mm_Horizontal
J18: Conn_02x03_Top_Bottom; Molex_Nano-Fit_105310-xx06_2x03_P2.50mm_Vertical
J19, J21: Conn_01x02; TerminalBlock_WAGO_236-402_1x02_P5.00mm_45Degree
J_I2C1, J_I2C_Jetson1: Conn_02x02_Counter_Clockwise; Molex_Nano-Fit_105309-xx04_1x04_P2.50mm_Vertical
J_JETSON_1: Conn_01x02; AMASS_XT60-F_1x02_P7.20mm_Vertical
J_PERIPHERAL1, J_PERIPHERAL2, J_PERIPHERAL3: Conn_01x02; AMASS_XT60-F_1x02_P7.20mm_Vertical
J_ROCKET1: Conn_01x02; AMASS_XT60-F_1x02_P7.20mm_Vertical
NT1: NetTie_2
PS1: THN_10-4815WIR; CONV_THN_10-4815WIR; PARTREV Jan 27, 2021
Q1, Q2, Q3, Q4, Q5, Q6, Q7, Q8: Q_PMOS_GDS; PowerPAK_SO-8_Single
Q9, Q10, Q11, Q12, Q13, Q14, Q15, Q16, Q17, Q18, Q19, Q20, Q21, Q22: Q_NMOS_GDS; PowerPAK_SO-8_Single
R1, R2, R3, R4, R5, R6, R7, R8: 100k; R_0805_2012Metric_Pad1.20x1.40mm_HandSolder
R9, R12, R15, R18, R21, R24, R27: 10; R_0805_2012Metric_Pad1.20x1.40mm_HandSolder
R10, R13, R16, R19, R22, R25, R28: 1K; R_0805_2012Metric_Pad1.20x1.40mm_HandSolder
R11, R14, R17, R20, R23, R26, R29: 100; R_0805_2012Metric_Pad1.20x1.40mm_HandSolder
R30, R31, R32, R33: 33; R_0805_2012Metric_Pad1.20x1.40mm_HandSolder
RA1, RA2, RA3, RA4, RA5, RA6, RA7: 100; R_0805_2012Metric_Pad1.20x1.40mm_HandSolder
RI1, RI2: 0.04; R_0805_2012Metric_Pad1.20x1.40mm_HandSolder
U1, U2, U3, U4, U5, U6, U7: LTC4372CDD-PBF; 05-08-1698_ADI
U8, U9, U10, U11, U12, U13, U14: ACS770xCB-050U-PFF; Allegro_CB_PFF
U15: ADC128S052CIMT; SOP65P640X120-16N
U17: TLV70033_SOT23-5; SOT-23-5

Connections:
/3.3V: C22.1, C50.1, U15.13 (VD), U17.5 (OUT)
/5V_PSO: C54.1, IC2.1 (SENSE+), IC2.2 (VIN), J21.2, RI2.1
/5V_REGULATED: C23.1, C24.1, C35.1, C36.1, C37.1, C38.1, C39.1, C40.1, C41.1, C42.1, C43.1, C44.1, C45.1, C46.1, C47.1, C48.1, C49.1, IC2.10 (SENSE-), J_JETSON_1.2, J_PERIPHERAL1.2, J_PERIPHERAL2.2, J_PERIPHERAL3.2, RI2.2, U8.1 (VCC), U9.1 (VCC), U10.1 (VCC), U11.1 (VCC), U12.1 (VCC), U13.1 (VCC), U14.1 (VCC), U15.2 (VA), U17.1 (IN)
/24V_PRESENSE: IC1.1 (SENSE+), IC1.2 (VIN), PS1.4 (+VOUT), RI1.1
/24V_PSO: D8.1 (K), J18.1, Q8.3 (S)
/24V_REGULATED: IC1.10 (SENSE-), J_ROCKET1.2, RI1.2
/24V_UNREGULATED: C51.2, C52.1, D9.1 (K), D10.1 (K), J18.2, J19.1, PS1.1 (+VIN(VCC))
/ADC_1_CS: R30.2, U15.1 (~CS)
/ADC_1_DIN: R32.2, U15.14 (DIN)
/ADC_1_DOUT: R31.2, U15.15 (DOUT)
/ADC_1_SCLK: R33.1, U15.16 (SCLK)
/BATT_1: H11.1, U8.5 (IP-)
/BATT_1_PRESENSE: Q9.2 (D), U1.1 (OUT), U8.4 (IP+)
/BATT_1_SENSE: RA1.1, U8.3 (VIOUT)
/BATT_2: H14.1, U9.5 (IP-)
/BATT_2_PRESENSE: Q11.2 (D), U2.1 (OUT), U9.4 (IP+)
/BATT_2_SENSE: RA2.1, U9.3 (VIOUT)
/BATT_3: H17.1, U10.5 (IP-)
/BATT_3_PRESENSE: Q13.2 (D), U3.1 (OUT), U10.4 (IP+)
/BATT_3_SENSE: RA3.1, U10.3 (VIOUT)
/BATT_4: H19.1, U11.5 (IP-)
/BATT_4_PRESENSE: Q15.2 (D), U4.1 (OUT), U11.4 (IP+)
/BATT_4_SENSE: RA4.1, U11.3 (VIOUT)
/BATT_5: H12.1, U12.5 (IP-)
/BATT_5_PRESENSE: Q17.2 (D), U5.1 (OUT), U12.4 (IP+)
/BATT_5_SENSE: RA5.1, U12.3 (VIOUT)
/BATT_6: H15.1, U13.5 (IP-)
/BATT_6_PRESENSE: Q19.2 (D), U6.1 (OUT), U13.4 (IP+)
/BATT_6_SENSE: RA6.1, U13.3 (VIOUT)
/BATT_7: H18.1, U14.5 (IP-)
/BATT_7_PRESENSE: Q21.2 (D), U7.1 (OUT), U14.4 (IP+)
/BATT_7_SENSE: RA7.1, U14.3 (VIOUT)
/BATT_IN_12_1: D1.1 (K), Q1.3 (S), Q10.2 (D), U1.4 (IN)
/BATT_IN_12_2: D2.1 (K), Q2.3 (S), Q12.2 (D), U2.4 (IN)
/BATT_IN_12_3: D3.1 (K), Q3.3 (S), Q14.2 (D), U3.4 (IN)
/BATT_IN_12_4: D4.1 (K), Q4.3 (S), Q16.2 (D), U4.4 (IN)
/BATT_IN_12_5: D5.1 (K), Q5.3 (S), Q18.2 (D), U5.4 (IN)
/BATT_IN_12_6: D6.1 (K), Q6.3 (S), Q20.2 (D), U6.4 (IN)
/BATT_IN_12_7: D7.1 (K), Q7.3 (S), Q22.2 (D), U7.4 (IN)
/SCL: IC1.6 (SCL), IC2.6 (SCL), J_I2C1.4, J_I2C_Jetson1.1
/SDA: IC1.7 (SDA), IC2.7 (SDA), J_I2C1.1, J_I2C_Jetson1.4
/SHDN: J18.5, U1.7 (2UPU), U1.8 (SHDN), U2.7 (2UPU), U2.8 (SHDN), U3.7 (2UPU), U3.8 (SHDN), U4.7 (2UPU), U4.8 (SHDN), U5.7 (2UPU), U5.8 (SHDN), U6.7 (2UPU), U6.8 (SHDN), U7.7 (2UPU), U7.8 (SHDN)
GND: C1.2, C3.2, C5.2, C7.2, C9.2, C11.2, C13.2, C15.2, C16.2, C17.2, C18.2, C19.2, C20.2, C21.2, C23.2, C24.2, C35.2, C36.2, C37.2, C38.2, C39.2, C40.2, C41.2, C42.2, C43.2, C44.2, C45.2, C46.2, C47.2, C48.2, C49.2, C50.2, C51.1, C52.2, C54.2, D9.2 (A), D10.2 (A), H13.1, H16.1, H20.1, H21.1, H22.1, H23.1, H24.1, IC1.4 (ADR0), IC1.5 (ADIN), IC1.9 (GND), IC2.3 (ADR1), IC2.4 (ADR0), IC2.5 (ADIN), IC2.9 (GND), J1.2, J2.2, J3.2, J4.2, J5.2, J6.2, J7.2, J8.2, J18.4, J19.2, J21.1, J_JETSON_1.1, J_PERIPHERAL1.1, J_PERIPHERAL2.1, J_PERIPHERAL3.1, J_ROCKET1.1, PS1.2 (-VIN(GND)), PS1.6 (-VOUT), R1.2, R2.2, R3.2, R4.2, R5.2, R6.2, R7.2, R8.2, R11.2, R14.2, R17.2, R20.2, R23.2, R26.2, R29.2, U1.9 (GND), U2.9 (GND), U3.9 (GND), U4.9 (GND), U5.9 (GND), U6.9 (GND), U7.9 (GND), U8.2 (GND), U9.2 (GND), U10.2 (GND), U11.2 (GND), U12.2 (GND), U13.2 (GND), U14.2 (GND), U15.3 (AGND), U17.2 (GND)
GNDD: C22.2, J9.2, J9.5, J_I2C1.2, J_I2C1.3, J_I2C_Jetson1.2, J_I2C_Jetson1.3, NT1.2, U2.12, U15.12 (DGND)
unnamed: C1.1, R10.2
unnamed: C2.1, R11.1, U1.6 (GND)
unnamed: C3.1, R13.2
unnamed: C4.1, R14.1, U2.6 (GND)
unnamed: C5.1, R16.2
unnamed: C6.1, R17.1, U3.6 (GND)
unnamed: C7.1, R19.2
unnamed: C8.1, R20.1, U4.6 (GND)
unnamed: C9.1, R22.2
unnamed: C10.1, R23.1, U5.6 (GND)
unnamed: C11.1, R25.2
unnamed: C12.1, R26.1, U6.6 (GND)
unnamed: C13.1, R28.2
unnamed: C14.1, R29.1, U7.6 (GND)
unnamed: D1.2 (A), Q1.1 (G), R1.1
unnamed: D2.2 (A), Q2.1 (G), R2.1
unnamed: D3.2 (A), Q3.1 (G), R3.1
unnamed: D4.2 (A), Q4.1 (G), R4.1
unnamed: D5.2 (A), Q5.1 (G), R5.1
unnamed: D6.2 (A), Q6.1 (G), R6.1
unnamed: D7.2 (A), Q7.1 (G), R7.1
unnamed: D8.2 (A), Q8.1 (G), R8.1
unnamed: F1.1, J1.1
unnamed: F2.1, J2.1
unnamed: F3.1, J3.1
unnamed: F4.1, J4.1
unnamed: F5.1, J5.1
unnamed: F6.1, J6.1
unnamed: F7.1, J7.1
unnamed: F8.1, J8.1
unnamed: J9.1, R33.2
unnamed: J9.3, R32.1
unnamed: J9.4, R30.1
unnamed: J9.6, R31.1
unnamed: F1.2, Q1.2 (D)
unnamed: F2.2, Q2.2 (D)
unnamed: F3.2, Q3.2 (D)
unnamed: F4.2, Q4.2 (D)
unnamed: F5.2, Q5.2 (D)
unnamed: F6.2, Q6.2 (D)
unnamed: F7.2, Q7.2 (D)
unnamed: F8.2, Q8.2 (D)
unnamed: Q9.1 (G), R9.1, R10.1, U1.2 (GATE)
unnamed: Q10.1 (G), R9.2
unnamed: Q9.3 (S), Q10.3 (S), U1.3 (SOURCE)
unnamed: Q11.1 (G), R12.1, R13.1, U2.2 (GATE)
unnamed: Q11.3 (S), Q12.3 (S), U2.3 (SOURCE)
unnamed: Q12.1 (G), R12.2
unnamed: Q13.1 (G), R15.1, R16.1, U3.2 (GATE)
unnamed: Q13.3 (S), Q14.3 (S), U3.3 (SOURCE)
unnamed: Q14.1 (G), R15.2
unnamed: Q15.1 (G), R18.1, R19.1, U4.2 (GATE)
unnamed: Q15.3 (S), Q16.3 (S), U4.3 (SOURCE)
unnamed: Q16.1 (G), R18.2
unnamed: Q17.1 (G), R21.1, R22.1, U5.2 (GATE)
unnamed: Q17.3 (S), Q18.3 (S), U5.3 (SOURCE)
unnamed: Q18.1 (G), R21.2
unnamed: Q19.1 (G), R24.1, R25.1, U6.2 (GATE)
unnamed: Q19.3 (S), Q20.3 (S), U6.3 (SOURCE)
unnamed: Q20.1 (G), R24.2
unnamed: Q21.1 (G), R27.1, R28.1, U7.2 (GATE)
unnamed: Q21.3 (S), Q22.3 (S), U7.3 (SOURCE)
unnamed: Q22.1 (G), R27.2
unnamed: C2.2, U1.5 (INTVCC)
unnamed: C4.2, U2.5 (INTVCC)
unnamed: C6.2, U3.5 (INTVCC)
unnamed: C8.2, U4.5 (INTVCC)
unnamed: C10.2, U5.5 (INTVCC)
unnamed: C12.2, U6.5 (INTVCC)
unnamed: C14.2, U7.5 (INTVCC)
unnamed: C15.1, RA1.2, U15.4 (IN0)
unnamed: C16.1, RA2.2, U15.5 (IN1)
unnamed: C17.1, RA3.2, U15.6 (IN2)
unnamed: C18.1, RA4.2, U15.7 (IN3)
unnamed: C19.1, RA5.2, U15.8 (IN4)
unnamed: C20.1, RA6.2, U15.9 (IN5)
unnamed: C21.1, RA7.2, U15.10 (IN6)

Notes on the sheet:
Battery Monitors (5V and 24V)
Parallel, Shutdown Circuitry
Battery Connectors
Buck Converters
Current Monitors
Output connectors
Battery Monitor ADC
Hex Address: D6
Hex Address: DE

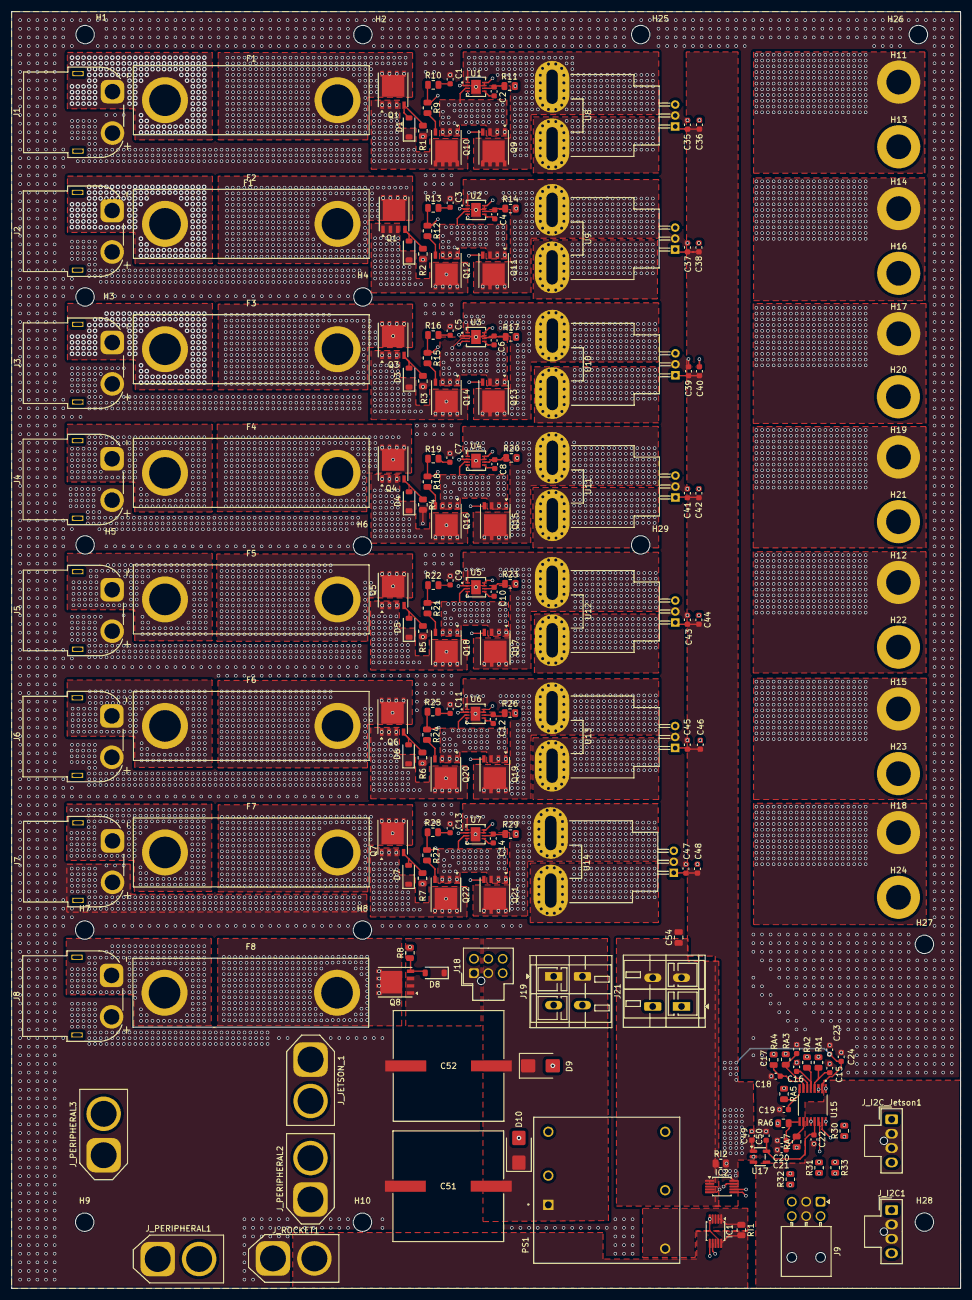
[picture p10: board Power Board.kicad_pcb from above]

Board: 4 copper layers, 165.0 x 222.0 mm, 192 parts (0 on the bottom side), 121 nets.
