princeton-rover-team/electrical/Peripherals Board/Peripherals Board (new).kicad_pcb

## KiCad design Peripherals Board/Peripherals Board (new).kicad_pcb (2024-01-31)

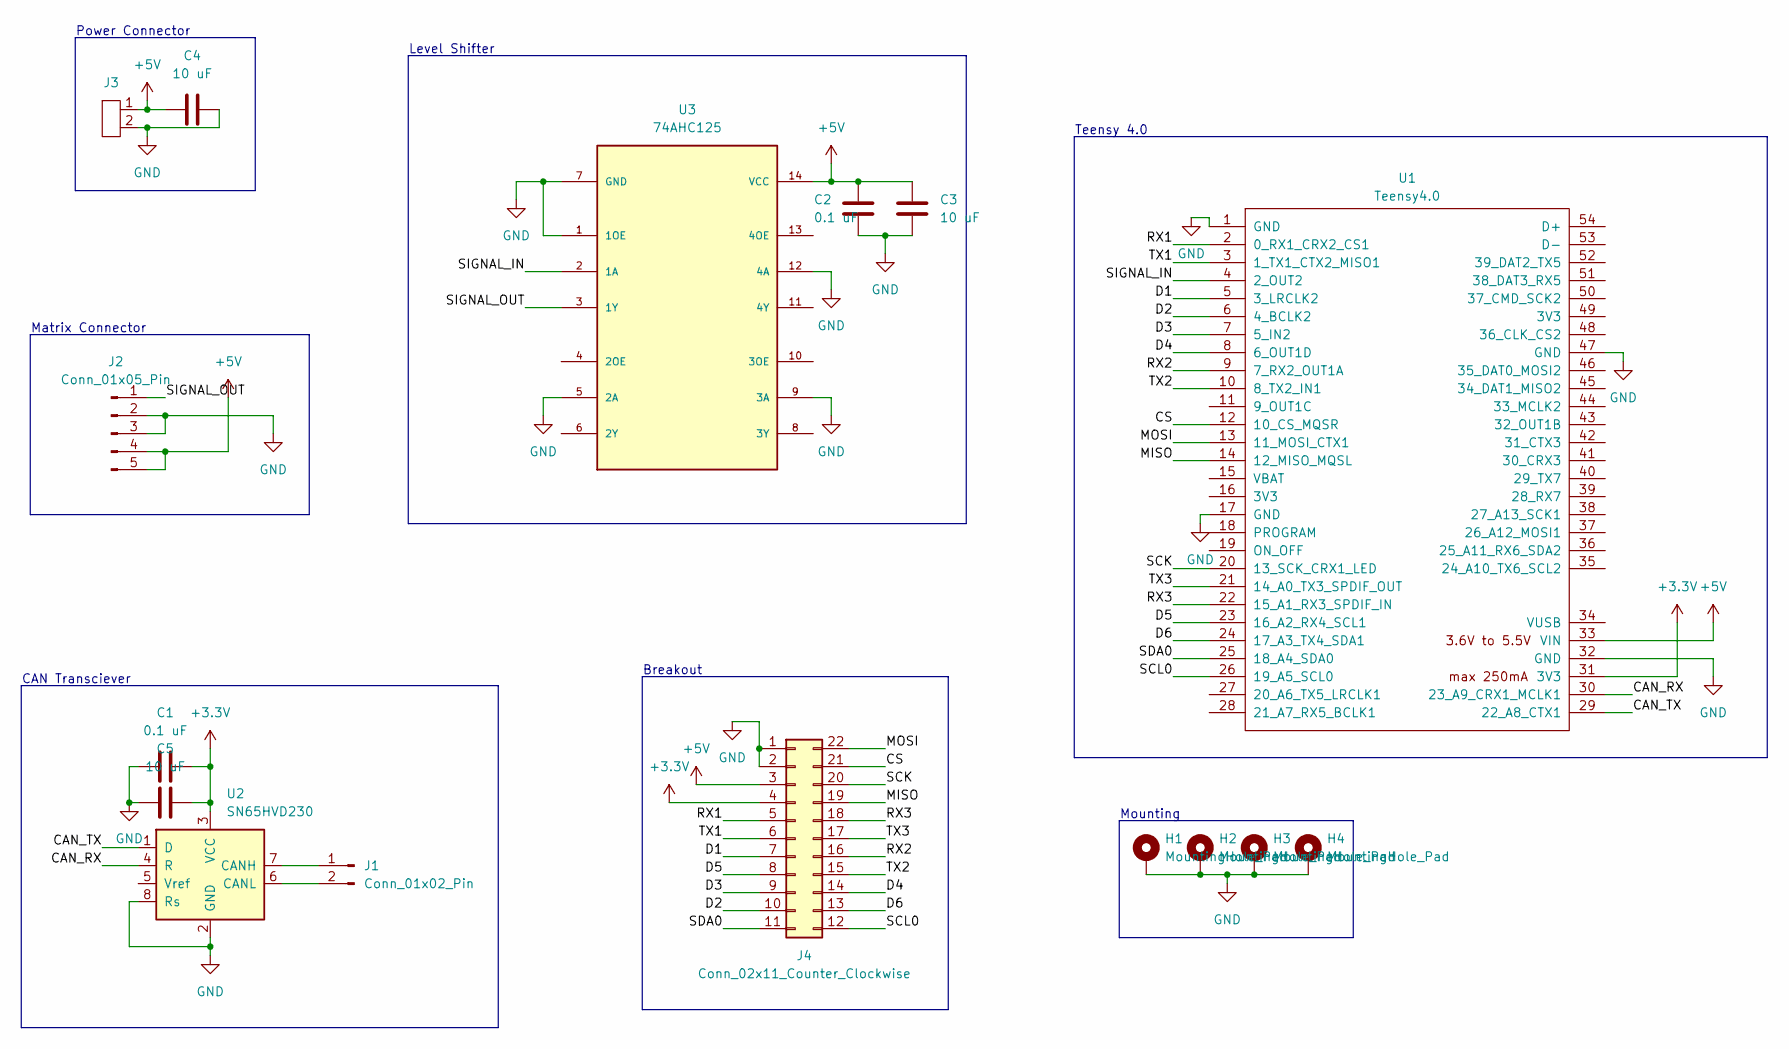
[picture p11: schematic Peripherals Board (new).kicad_sch]

Parts:
C1, C2: 0.1 uF; C_0805_2012Metric
C3, C4, C5: 10 uF; C_0805_2012Metric
H1, H2, H3, H4: MountingHole_Pad; MountingHole_2.2mm_M2_Pad
J1: Conn_01x02_Pin; JST_GH_BM02B-GHS-TBT_1x02-1MP_P1.25mm_Vertical
J2: Conn_01x05_Pin; JST_GH_BM05B-GHS-TBT_1x05-1MP_P1.25mm_Vertical
J3: XT30PW-M
J4: Conn_02x11_Counter_Clockwise; PinSocket_2x11_P2.54mm_Vertical
U1: Teensy4.0; Teensy40
U2: SN65HVD230; SOIC-8_3.9x4.9mm_P1.27mm
U3: 74AHC125; SO-14_3.9x8.65mm_P1.27mm

Connections:
+3.3V: C1.1, C5.2, J4.4, U1.31 (3V3), U2.3 (VCC)
+5V: C2.1, C3.1, C4.2, J2.4, J2.5, J3.1 (A), J4.3, U1.33 (VIN), U3.14 (VCC)
/CAN_RX: U1.30 (23_A9_CRX1_MCLK1), U2.4 (R)
/CAN_TX: U1.29 (22_A8_CTX1), U2.1 (D)
/CS: J4.21, U1.12 (10_CS_MQSR)
/D1: J4.7, U1.5 (3_LRCLK2)
/D2: J4.10, U1.6 (4_BCLK2)
/D3: J4.9, U1.7 (5_IN2)
/D4: J4.14, U1.8 (6_OUT1D)
/D5: J4.8, U1.23 (16_A2_RX4_SCL1)
/D6: J4.13, U1.24 (17_A3_TX4_SDA1)
/MISO: J4.19, U1.14 (12_MISO_MQSL)
/MOSI: J4.22, U1.13 (11_MOSI_CTX1)
/RX1: J4.5, U1.2 (0_RX1_CRX2_CS1)
/RX2: J4.16, U1.9 (7_RX2_OUT1A)
/RX3: J4.18, U1.22 (15_A1_RX3_SPDIF_IN)
/SCK: J4.20, U1.20 (13_SCK_CRX1_LED)
/SCL0: J4.12, U1.26 (19_A5_SCL0)
/SDA0: J4.11, U1.25 (18_A4_SDA0)
/SIGNAL_IN: U1.4 (2_OUT2), U3.2 (1A)
/SIGNAL_OUT: J2.1, U3.3 (1Y)
/TX1: J4.6, U1.3 (1_TX1_CTX2_MISO1)
/TX2: J4.15, U1.10 (8_TX2_IN1)
/TX3: J4.17, U1.21 (14_A0_TX3_SPDIF_OUT)
GND: C1.2, C2.2, C3.2, C4.1, C5.1, H1.1, H2.1, H3.1, H4.1, J2.2, J2.3, J3.2 (B), J4.1, J4.2, U1.1 (GND), U1.17 (GND), U1.32 (GND), U1.47 (GND), U2.2 (GND), U2.8 (Rs), U3.1 (1OE), U3.5 (2A), U3.7 (GND), U3.9 (3A), U3.12 (4A)
unnamed: J1.1, U2.7 (CANH)
unnamed: J1.2, U2.6 (CANL)

Notes on the sheet:
CAN Transciever
Level Shifter
Matrix Connector
Power Connector
Teensy 4.0
Mounting
Breakout

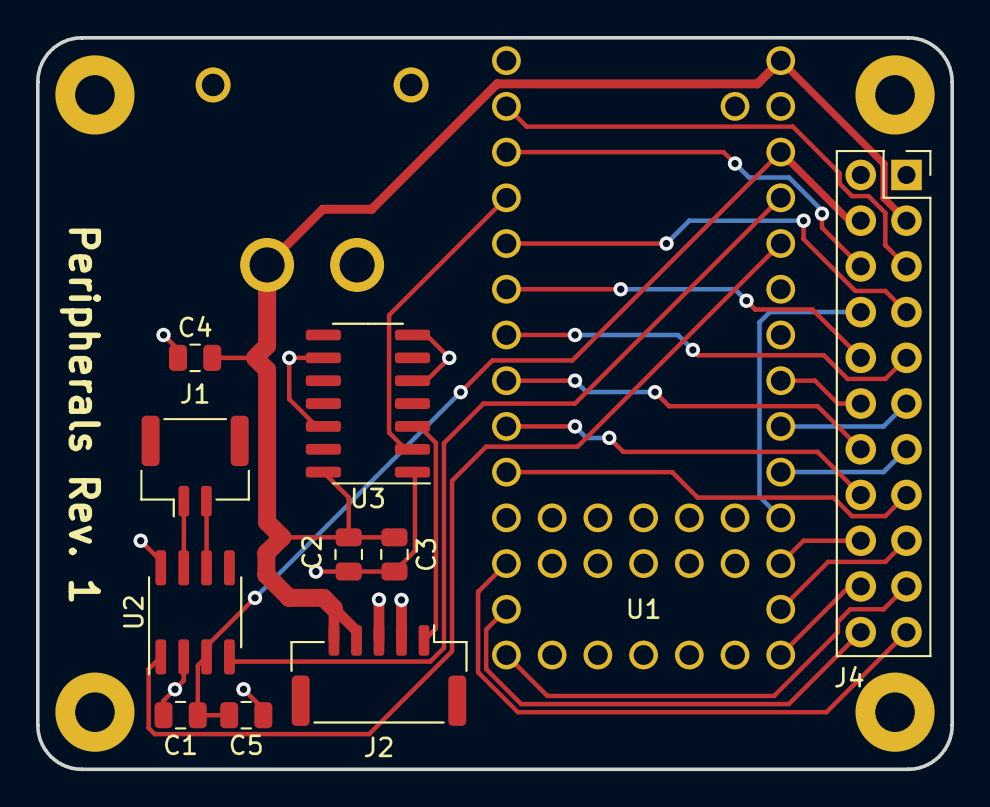
[picture p12: board Peripherals Board (new).kicad_pcb from above]

Board: 2 copper layers, 50.8 x 40.6 mm, 16 parts (0 on the bottom side), 27 nets.
