princeton-rover-team/electrical/(commit log)

2023-10-30 Added peripherals board
    [Adafruit_NeoMatrix_8x8 v2.kicad_pcb, Adafruit_NeoMatrix_8x8 v2.kicad_sch]
2023-11-05 Add footprints and layouts
    [Adafruit_NeoMatrix_8x8 v2.kicad_pcb, Adafruit_NeoMatrix_8x8 v2.kicad_sch]
2023-11-09 organized peripherals board schematic
    [Adafruit_NeoMatrix_8x8 v2.kicad_sch]
2023-11-09 initialized power board
    [Power Board.kicad_pcb, Power Board.kicad_sch]
2023-11-12 replace corrupted schematic file
    [Adafruit_NeoMatrix_8x8 v2.kicad_sch]
2023-11-12 Added CAN Bus software folder
2023-11-12 Got CAN transmission working between 2 teensy 4.0s
2024-01-31 remade peripherals board
    [Adafruit_NeoMatrix_8x8 v2.kicad_pcb, Adafruit_NeoMatrix_8x8 v2.kicad_sch, Peripherals Board (new).kicad_pcb, Peripherals Board (new).kicad_sch]
2024-01-31 minor changes
    [Peripherals Board (new).kicad_pcb]
2024-02-07 Worked more on peripherals board code
2024-02-18 Updated power board schematic and libraries
    [Power Board.kicad_pcb, Power Board.kicad_sch]
2024-02-18 feat: schematic for 8-channel single-ended ADC + symlib
    [4ChannelADC.kicad_pcb, 4ChannelADC.kicad_sch]
2024-02-18 Worked on gas gauge
    [Power Board.kicad_sch]
2024-03-24 working on power board
    [Power Board.kicad_sch]
2025-11-02 power board update
    [Peripherals Board (new).kicad_sch, Power Board.kicad_pcb, Power Board.kicad_sch]
2025-11-06 updated resistor values
    [Power Board.kicad_sch]
2025-11-07 added resistor and capacitor footprints
    [Power Board.kicad_pcb, Power Board.kicad_sch]
2025-11-16 connectors update
    [Motor Board.kicad_pcb, Motor Board.kicad_sch, Power Board.kicad_pcb, Power Board.kicad_sch]
2025-11-21 separated current sensors and updated ADCs, component numbering
    [Power Board.kicad_sch]
2025-12-03 updated schematic numbering, made rough PCB design for battery 1
    [Power Board.kicad_pcb, Power Board.kicad_sch]
2025-12-03 adc design on power board
    [Power Board.kicad_pcb, Power Board.kicad_sch]
2026-01-18 laid out most components, reworked battery 1 pours, made connections for ADCs; buck converter layout and routing in progress
    [Power Board 2.kicad_pcb, Power Board.kicad_pcb, Power Board.kicad_sch]
2026-01-21 changed ADC connectors, added series resistors
    [Power Board.kicad_pcb, Power Board.kicad_sch]
2026-01-23 updated LTC4372s, switch connector, ADC; added some power planes for other batteries
    [Power Board.kicad_pcb, Power Board.kicad_sch]
2026-01-24 more layout, power planes for 24V and 5V rails, current sensing and switch connections; might move digital section with ADCs and LTC4151s to bottom left
    [Power Board.kicad_pcb, Power Board.kicad_sch]
2026-01-28 Added the beginnings of the BMS schematic (the only parts in the schematic right now are JST-XH connectors and one chip). Added libraries for the battery monitoring/balancing chip: BQ76942
    [BMS Board.kicad_pcb, BMS Board.kicad_sch]
2026-02-05 aaryan jagtap
    [Power Board.kicad_pcb]
2026-02-05 removed thermistors and ADC; conserved space
    [Power Board.kicad_pcb]
2026-02-08 updated layout and pours
    [Power Board.kicad_pcb]
2026-02-08 updated xt60 connectors, routed ADC lines
    [Power Board.kicad_pcb, Power Board.kicad_sch]
2026-02-09 i2c routing
    [Power Board.kicad_pcb, Power Board.kicad_sch]
2026-02-12 moved bms stuff out of power board folder
    [BMS Board.kicad_pcb, BMS Board.kicad_sch]
2026-02-12 Delete Power Board/BMS Board directory
    moved out of the power board folder
    [BMS Board.kicad_pcb, BMS Board.kicad_sch]
2026-02-14 more pin configs for bq chip
    [BMS Board.kicad_pcb, BMS Board.kicad_sch]
2026-02-14 Delete BMS Board directory
    to resolve a merge conflict
    [BMS Board.kicad_pcb, BMS Board.kicad_sch]
2026-02-15 added M3 mounting holes, removed buck converter (to be replaced with half-brick), added more pours
    [Power Board.kicad_pcb, Power Board.kicad_sch]
2026-02-22 added XT60 connectors for 5V rail and standoffs for BMS, 5V converter
    [Power Board.kicad_pcb, Power Board.kicad_sch]
2026-02-26 pours battery presense
    [Power Board.kicad_pcb]
2026-02-26 pours battery
    [Power Board.kicad_pcb]
2026-02-27 minor tracing updates for batteries on PDB
    [Power Board.kicad_pcb, Power Board.kicad_sch]
2026-03-14 added some via stitching on pcb, to be completed
2026-03-14 new power board folder because github sucks
    [Power Board 2.kicad_pcb, Power Board.kicad_pcb, Power Board.kicad_sch]
2026-03-14 more via stitching
    [Power Board 2.kicad_pcb, Power Board.kicad_pcb]
2026-03-19 pours and vias for battery outputs
    [Power Board.kicad_pcb, Power Board.kicad_sch]
2026-03-20 screw terminals for 5V buck, pour + stitching
    [Power Board.kicad_pcb, Power Board.kicad_sch]
2026-03-22 changed mounting holes to without pad for star grounding
    [Power Board.kicad_pcb, Power Board.kicad_sch]
2026-04-23 power board minor changes
    [Power Board.kicad_pcb, Power Board.kicad_sch]
2026-05-18 via stitching on power board
    [Power Board.kicad_pcb]
2026-05-18 BMS schematic with individual monitoring ICs + I2C MUX
    [BMS Board.kicad_sch]
2026-05-18 started pcb layout for BMS board
    [BMS Board.kicad_pcb, BMS Board.kicad_sch]
2026-05-18 BMS layout for three batteries done
    [BMS Board.kicad_pcb, BMS Board.kicad_sch, Power Board.kicad_pcb]
2026-05-19 BMS pretty much completed
    [BMS Board.kicad_pcb, BMS Board.kicad_sch, Power Board.kicad_pcb]
2026-05-19 BMS completed + via stitching
    [BMS Board.kicad_pcb]
2026-05-19 added LED to monitor 5v power
    [BMS Board.kicad_pcb, BMS Board.kicad_sch]
2026-05-19 added mounting holes
    [BMS Board.kicad_pcb, BMS Board.kicad_sch, Power Board.kicad_pcb, Power Board.kicad_sch]
2026-05-28 minor updates to BMS; edge cuts, GND pour, via stitching, missed connections for PDB
    [BMS Board.kicad_pcb, BMS Board.kicad_sch, Power Board.kicad_pcb]
2026-09-24 Changed Resistance and Capacitance Vals for BQ..30 board
    [BMS Board.kicad_sch]
2026-09-24 used LDO output from BMs to Mux, routed PCB
    [BMS Board.kicad_pcb, BMS Board.kicad_sch]
2026-09-24 small fix on wire label
    [BMS Board.kicad_sch]
2026-10-13 changed cap value in power board pcb according to datasheet calc
